PeiaLo/RS485C/README.md

# RS485_C — 多層樹狀傳感器網路

以 RS485 為傳輸骨幹的**多層樹狀**傳感器資料收集系統。頂層為 PC，往下經多層**中繼器**，末端接各類**傳感器模組**（溫度、壓力…）。最終用於**工廠端即時資料收集**：把傳統 PLC 資料轉為 PC 架構，客戶端可即時讀值、設定條件達成自動控制。

> 本專案接替並取代舊的 `R_C_MOD`。與 `ACL_001`（酒測儀）為完全獨立的兩個項目。

---

## 一分鐘理解

```
PC (頂層, 5V / 未來 Ethernet·WiFi)
 └─ RS485 bus (第1層)
     ├─ 中繼器 1  ── RS485 bus (第2層) ── 傳感器 / 更下層中繼器 …
     ├─ 中繼器 2
     └─ …(單一 bus 最多 64 台)
```

- 每台**中繼器**同時扮演兩個角色：對**上層**是 slave（被要求才回話），對**下層**是 master（主動輪詢）。
- 資料流是「**下層一直輪詢+暫存(cache)，上層要才給**」——把 PC 的讀取速度和下層 bus 速度解耦。
- 每台設備都靠**7 階指撥開關**定址；換機時預載好 JSON、撥同一位址即可直接替換。

## 文件導覽

| 文件 | 內容 |
|---|---|
| [docs/01_系統架構.md](docs/01_系統架構.md) | 整體拓樸、角色、資料流、cache 模型（含圖） |
| [docs/02_通訊協定.md](docs/02_通訊協定.md) | `\n`/`\r` byte 串流框架、輪詢時序、逾時、傳輸內容格式 |
| [docs/03_定址與指撥開關.md](docs/03_定址與指撥開關.md) | 7 階指撥、6 位址 + 1 功能、字串分層位址、層數判定 |
| [docs/04_軟體模組拆分.md](docs/04_軟體模組拆分.md) | 6 個可分頭開發的模組、介面契約、開發順序 |
| [docs/05_測試架構建議.md](docs/05_測試架構建議.md) | 用手上硬體（STM32/Nucleo/UNO/ESP32/MAX13487）分階段驗證 |
| [docs/06_設計決策與待確認.md](docs/06_設計決策與待確認.md) | 開放問題、風險、需要你拍板的地方 |
| [docs/07_採購清單.md](docs/07_採購清單.md) | 非陸製 BOM / 採購清單、手上硬體盤點 |
| [子專案/](子專案/00_拆分總覽.md) | **分對話開發用**：6 個模組的 kickoff brief，各含「貼到新對話的開場白」 |
| [schema/](schema/) | 設備 JSON schema 與範例（溫度、壓力） |
| [firmware/](firmware/) | 末端(Arduino) 與 中繼器(MicroPython) 韌體骨架 |
| [pc/](pc/) | PC 上位機骨架 |

## 技術棧

- **末端傳感器模組**：Arduino（C++），單純驅動 + 讀指撥 + 打包傳輸。
- **中繼器**：MicroPython（ESP32），善用 `list`/`dict` 做輪詢佇列與 cache。
- **PC 上位機**：Python（序列埠 / 未來 Ethernet），儀表板 + 規則引擎。
- **RS485 收發器**：MAX13487（AutoDirection，免 DE/RE 方向控制腳）。

## 目前狀態

規格已整理成文件（本次），韌體/軟體為骨架，尚未實作。建議先確定 [docs/06](docs/06_設計決策與待確認.md) 的待拍板項目，並先凍結 [docs/02 通訊協定](docs/02_通訊協定.md) 當作各模組共用契約，再分頭進行。
