PeiaLo/RS485C/docs/07_採購清單.md

# 07 · 採購清單 / BOM（非陸製）

**原則**：晶片產地非中國。ST（歐）、Microchip/TI/ADI（美）、WIZnet（韓）、Semtech（美）、Nordic（挪）、Infineon（德/美）。避開 Espressif(ESP32，中國) 與內含 ESP32 的模組（如 u-blox NINA-W1）。

> 開發板（Blue/Black Pill、UNO 相容板）多為中國組裝但晶片是真的 → **打樣可用；產品走自己的 PCB + 原廠晶片**。Blue Pill F103 常見克隆晶片，產品務必買原廠 ST。

## v2 節點硬體增減（vs 舊 DIP 版，2026-10-13）

> 回答「除了 DIP 去掉還要增減什麼」。細節見 [10](10_自動終端與拓樸.md)、[06 §O](06_設計決策與待確認.md)。

**➕ 新增**
| 件 | 用途 | 代價 |
|---|---|---|
| **ENUM 鏈線 + 2 GPIO/節點** | 自動定址枚舉（`ENUM_IN` 讀 / `ENUM_OUT` 驅） | 連接器 +1 pin、2 GPIO |
| **0.1Ω shunt + INA180**（每節點對下游電源線） | 偵測「我是不是尾」→ 自動終端 + 鏈完整性 | ~260µA/台、1 ADC/比較腳 |
| **可切換終端** | 尾端 120Ω 自動投切（THVD1454 內建，或 PhotoMOS+120Ω） | +1 TERM GPIO |
| **連接器加 pin** | in/out 同順序串 A/B/GND/V+/**ENUM** | 連接器升一級 |
| **頭段 adapter（頂層，可插拔）** | WiFi（非陸製 WINC1500/CYW43439）或 W5500 乙太 | 僅頂層 1 顆 |
| **中繼器第 3 收發器/UART** | UP + DOWN-trunk + DOWN-leaf（[10 §1](10_自動終端與拓樸.md)） | RP2040 需 PIO-UART 或改 STM32 多 USART |
| **末端第 2 RS485 收發器** | 尾段 MODBUS master@115200 對外部外設 | 要接外部外設才需 |

**➖ 移除**
| 件 | 原因 |
|---|---|
| **DIP 開關(7位) + 7 GPIO / 74HC165** | 自動定址取代 |
| **固定焊死尾端 120Ω** | 改可切換自動投切（頭端仍固定 120Ω） |
| **偏壓電阻 2×560Ω/bus** | 改 true fail-safe 收發器 → 免偏壓 |
| **分壓電阻 1.8k/3.3k（RO→RX）** | 改 3.3V 原生 fail-safe 件 → 免分壓 |
| **RST 腳** | 軟體重開（記憶 `firmware-soft-reset`） |
| **AutoDir 收發器(MAX13487)** | 改手動 DE/RE fail-safe 件（+1 DE/RE GPIO，但省偏壓） |

**◻ 不影響硬體**：CRC（純軟體、初期不設、後可加）、自動定址枚舉協定（軟體，只需 ENUM 腳）。

> 淨效果：**省掉 DIP/74HC165/偏壓/分壓/固定終端電阻**，**換來 ENUM 1 線 + INA180/可切換終端 + fail-safe 收發器 + 連接器升級**。整體往「自主、免設定、免手調電阻」走，契合 [10](10_自動終端與拓樸.md) 自動終端路線。

## 手上已有（2026-08-20）
| 品項 | 數量 | 用途 |
|---|---|---|
| Nucleo-F401RE | 2 | 原型／可當末端（**MicroPython 中繼器改用 RP2040**：F401RE build 僅 1 UART，見 [06 §J](06_設計決策與待確認.md)） |
| STM32F401 裸板 | 1 | 末端/備用 |
| STM32F103 | 2 | C++ 末端測試（無 FPU，正式末端首選 F411） |
| MAX13487EES | 10 | RS485 收發器（AutoDirection，現行主用；選型另見 [08 §3.2](08_末端外設_Driver_韌性架構.md)） |
| THVD1426DR | 2 | RS485 收發器（TI，二供備用） |

## 要採購

### MCU
| 角色 | 建議料 | 產地 | 備註 |
|---|---|---|---|
| **中繼器**（MicroPython） | **RP2040**（YD-RP2040 / Pico 等） | Raspberry Pi 🇬🇧 | **雙 UART**（選它主因）；`dict/json` 用於型錄/hot-swap |
| **高速傳送型中繼器** | RP2040 + **W5500** | 🇬🇧/🇰🇷 | Ethernet 骨幹/頂層 |
| **計算與驅動型中繼器** | Raspberry Pi（Python） | 🇬🇧/🇺🇸 | 複雜多迴路 |
| **末端**（C++，通用） | **STM32F411**（F411CEU6 / Nucleo-F411RE） | ST 🇪🇺 | M4F+FPU、16ch ADC、5V 容忍腳；預設料 |
| 末端（重運算/大 cache） | STM32F7 / **H743** / N6 | ST | M7+cache / DP-FPU+16-bit ADC+雙核 / NPU（見 [08 §3.1](08_末端外設_Driver_韌性架構.md)） |
| 末端（測試/低階） | STM32F103（原廠） | ST | 無 FPU，僅測試用 |

### RS485 / 網路 / 無線
| 品項 | 料號 | 產地 | 備註 |
|---|---|---|---|
| RS485 收發器（現行主用） | **MAX13487EES** | ADI 🇺🇸 | AutoDirection，免 DE/RE，但需偏壓。**每末端 1、每中繼器 2** |
| RS485 收發器（選型建議） | **MAX13485E** / TI **THVD2450**·SN65HVD75 | ADI/TI 🇺🇸 | true fail-safe **免偏壓**（3.3V 件免分壓）；見 [08 §3.2](08_末端外設_Driver_韌性架構.md) |
| RS485 收發器（二供） | THVD1426 / THVD1450 | TI 🇺🇸 | 確認方向控制方式（多數 THVD14xx 需 DE/RE GPIO） |
| 頭段有線（頂層，首選） | **WIZnet W5500**（配 RP2040） | WIZnet 🇰🇷 | 乙太，SPI、內建硬體 TCP/IP |
| **頭段無線（頂層，扛大量資訊）** | **Microchip WINC1500** / Infineon **CYW43439** | 🇺🇸/🇩🇪 | **WiFi，非陸製**（ESP32 排除）；查最新供貨。見 [06 §O](06_設計決策與待確認.md) |
| 無線（暫緩，若走 LoRa） | **STM32WL** 或 Semtech SX1262 | ST🇪🇺 / Semtech🇺🇸 | STM32WL＝MCU+LoRa 一顆；低頻寬，只適遠端稀疏節點 |

### 被動件 / 其他（每條 bus / 每節點）
| 品項 | 規格 | 說明 |
|---|---|---|
| 終端電阻 | 120Ω ×2/bus | bus 兩端各一（尾端自動投切，見 [10](10_自動終端與拓樸.md)） |
| Failsafe 偏壓 | 上拉 A、下拉 B（如 560Ω–1k） | 至少一處；或用 true fail-safe 件免偏壓 |
| ~~指撥開關~~ | — | **已拿掉**：改自動定址（[03](03_定址與指撥開關.md)、[10 §8](10_自動終端與拓樸.md)） |
| 自動定址/終端件 | INA180（電流偵測）+ ENUM 線 + 可切換終端件（THVD1454 等） | 自偵尾端 + ENUM 鏈枚舉，見 [10](10_自動終端與拓樸.md) |
| 分壓電阻 | 1k/2k | 5V 節點 TX/RO → 3.3V MCU RX |
| 連接器 | RS485 A/B/GND、電源、**ENUM**（in/out 同順序串接） | 依板，見 [10 §4/§8](10_自動終端與拓樸.md) |
| 燒錄器 | ST-Link | Nucleo 已內建 |

## 自製板（雕刻機）
- 先做**兩層**測試；避免麵包板混亂 → 雕刻機刻板（線寬 > 0.35mm，RS485 低速綽綽有餘）。
- 建議先刻：①末端節點板（MCU + 收發器 + INA180/ENUM 自動定址 + 接頭）②bus 背板/接線板（含終端+偏壓）。要我出簡單板子的佈局再說。
