PeiaLo/RS485C/docs/04_軟體模組拆分.md

# 04 · 軟體模組拆分（分頭開發）

> ⚠️ **平台/編碼以 [09 軟體架構定案](09_軟體架構定案.md) 為準**：末端=**C++/STM32**、中繼器=**MicroPython/RP2040**、傳輸層=**RS485↔Ethernet(W5500)**、編碼=**DESC=JSON/REQ=純值CSV+CRC**。本文保留模組拆分脈絡，平台字樣已同步更新。

目標：把系統切成**可獨立、可平行開發**的模組，彼此只靠[通訊協定 02](02_通訊協定.md) 與 [JSON schema](../schema) 這兩份「契約」對接。**先凍結契約，再分頭做。**

## 模組總覽

```mermaid
graph LR
    C[C 共用協定庫<br/>framing + 位址字串<br/>C++ & Python 兩版]

    A[A 末端傳感器韌體<br/>C++ / STM32] -->|用| C
    B[B 中繼器韌體<br/>MicroPython / RP2040] -->|用| C
    D[D PC 上位機<br/>Python] -->|用| C
    E[E JSON schema + 設備庫] -.驗證.-> A
    E -.載入.-> B
    E -.顯示.-> D
    F[F 傳輸層抽象<br/>RS485 ↔ Ethernet] -.可插拔.-> B
    F -.可插拔.-> D

    classDef contract fill:#3a2f5f,stroke:#9a7bd9,color:#fff;
    class C,E contract;
```

## 各模組規格

### 模組 C — 共用協定庫（**最先做，是契約**）
- **內容**：`\n`/`\r` 框架的**編碼/解碼**、位址字串操作（前綴、切段、驗證）、（可選）CRC。
- **兩份實作**（行為必須一致）：
  - `protocol.h/.cpp`（C++，給模組 A）
  - `protocol.py`（Python，給模組 B 的 MicroPython 與模組 D 的 CPython 共用）
- **交付**：一組跨語言一致的單元測試向量（同一輸入 → 同一輸出），確保三邊實作對得上。
- **負責人**：定義協定的人；其他模組等這個先定版。

### 模組 A — 末端傳感器韌體（C++ / STM32）
- **平台**：STM32（F411 通用 → F7/H7 重運算，見 [08 §3.1](08_末端外設_Driver_韌性架構.md)）。
- **職責（單純驅動 + 傳輸）**：
  1. 自動定址（ENUM 鏈序，取代指撥；見 [03](03_定址與指撥開關.md)、[10 §8](10_自動終端與拓樸.md)）。
  2. 讀感測器（driver 登錄表=函式指標），按 descriptor 指向值槽。
  3. 用模組 C 打包：`<本地位址>|<值CSV>*<crc>\r`（REQ 純值 CSV），被輪詢才回。
  4. 功能位 OFF 時進編輯模式，接受寫入自有 JSON/參數。
- **不做**：不輪詢、不 cache、不拼全路徑（那是中繼器的事）。
- **骨架**：[../firmware/stm32_terminal/](../firmware/stm32_terminal)

### 模組 B — 中繼器韌體（MicroPython / RP2040）
- **平台**：RP2040（MicroPython，雙 UART；`dict`/`json` 用在型錄/路由/hot-swap）。
- **職責**：
  1. **雙 UART**：上層 bus（slave 角色）+ 下層 bus（master 角色）。
  2. **輪詢迴圈**：round-robin 問下層每個孩子，收 `\r` 存 cache、逾時跳過。
  3. **cache**：`dict{本地位址: (最新完整資料, 時戳, fresh/stale)}`。
  4. **前綴**：把孩子資料前綴自己的本地位址，向上拼路徑。
  5. **上層要求優先**：被上層要就回 cache。
  6. **型錄**：載入所有已知設備 JSON（catalog）以辨識下層、支援 hot-swap。
- **骨架**：[../firmware/rp2040_repeater/](../firmware/rp2040_repeater)

### 模組 D — PC 上位機（Python）
- **職責**：
  1. 連線（序列埠；未來走模組 F 換 Ethernet）。
  2. **請求排程**：向第 1 層中繼器要資料（全部 / 指定位址）。
  3. 解析框架 → 更新設備即時值表。
  4. **設備資料庫**：用 JSON schema 呈現/驗證各設備。
  5. **即時儀表板**：即時數值、樹狀拓樸、新鮮度。
  6. **規則引擎**（[需求 17]）：使用者設條件（如溫度>X 觸發輸出）→ 自動控制輸出。
  7. Log / 匯出。
- **骨架**：[../pc/](../pc)

### 模組 E — JSON schema + 設備庫
- **內容**：設備 JSON 的 schema、各型別範例、驗證工具。
- **交付**：`device.schema.json` + 每種傳感器一個範例 + 驗證腳本。
- **骨架**：[../schema/](../schema)

### 模組 F — 傳輸層抽象（擴充，之後做）
- **動機**（[需求 11]）：層數/數量變多時 PC 端 RS485 接收會塞車 → 頂層鏈路改 Ethernet（RP2040+W5500）。
- **內容**：定義 `Link` 介面（`send_bytes` / `recv_bytes`），提供 `RS485Link` 與 `EthernetLink` 實作；模組 B（頂層中繼器）與模組 D 只依賴介面，不綁死實體層。WiFi/ESP32 排除（去陸製）。

## 建議開發順序

```mermaid
graph LR
    C[① 模組 C 協定庫<br/>+ 測試向量] --> E[② 模組 E schema]
    C --> A[③ 模組 A 末端]
    C --> B[④ 模組 B 中繼器]
    A --> T0[⑤ 兩節點對接<br/>見 05]
    B --> T0
    T0 --> D[⑥ 模組 D PC + 多層]
    D --> F[⑦ 模組 F 換 Ethernet]
```

1. **先定 C（協定）+ E（schema）** — 這是所有人共用的契約，先凍結。
2. A / B 可同時開工（都依 C）。
3. 先做 **A↔B 兩節點對接**（[05 測試 Stage 0](05_測試架構建議.md)）驗證框架與定址。
4. 再上 **D（PC）+ 多層樹**。
5. 最後 **F（Ethernet, W5500）** 解 PC 端瓶頸。

## 分工建議（若多人）

| 人 | 模組 | 前置依賴 |
|----|---|---|
| 韌體 A | A 末端(STM32/C++) + C 的 C++ 版 | 協定定版 |
| 韌體 B | B 中繼器(RP2040/MicroPython) + C 的 Python 版 | 協定定版 |
| 上位機 | D PC + 規則引擎 | 協定定版、schema |
| 資料/系統 | E schema + F 傳輸層 | — |
