PeiaLo/RS485C/子專案/00_拆分總覽.md

# 子專案拆分總覽

把 RS485_C 拆成可**分對話平行開發**的子專案。每個子專案一份 kickoff brief（本資料夾），
裡面有「**貼到新對話的開場白**」——新對話冷啟動時貼那段就能接上完整脈絡。

## 運作方式

- **單一 repo（mono-repo）**：https://github.com/PeiaLo/RS485C ，本機 `C:\Users\apial\Desktop\RS485_C`。
- 每個子專案 = repo 裡一個資料夾，**用各自的對話開發**，都 push 回同一個 repo。
- **共用契約**＝[docs/02 通訊協定](../docs/02_通訊協定.md) 與 [schema/](../schema)。任何模組**不可自行改契約**；要改先回「契約對話（C/E）」統一改，再讓大家 pull。
- 新對話開發流程：`git pull` → 改自己的資料夾 → commit → `git push`。其他對話 pull 就同步。

## 拆分地圖

| 子專案 | 資料夾 | 語言/平台 | 依賴 | 建議順序 | 狀態 |
|---|---|---|---|---|---|
| [C 協定庫](C_協定庫.md) | `lib/` | C++ & Python | — | **①先做（契約）** | 已抽出 `lib/protocol.*`；CRC-16 待啟用 |
| [E JSON schema](E_schema.md) | `schema/` | JSON | — | **①先做（契約）** | schema+範例已建，待驗證腳本 |
| [A 末端韌體](A_末端韌體.md) | `firmware/stm32_terminal/` | **C++ / STM32**（F411…H7） | C | ② | 深鏈末端已驗通（健康監測+IWDG） |
| [B 中繼器韌體](B_中繼器韌體.md) | `firmware/rp2040_repeater/` | **MicroPython / RP2040** | C, E | ② | 深鏈 3 層中繼已驗通（前綴+cache 解耦） |
| [D PC 上位機](D_PC上位機.md) | `pc/` | Python | C, E | ③ | 已有 `rs485_monitor.py`/`rs485_probe.py`；上位機待實作 |
| [F 傳輸層](F_傳輸層.md) | `pc/`, `firmware/` | **Python / RP2040(W5500)** | B, D | ④ 擴充 | 只有概念 |

## 依賴與順序

```mermaid
graph LR
    C[C 協定庫 契約] --> A[A 末端]
    C --> B[B 中繼器]
    C --> D[D PC]
    E[E schema 契約] --> B
    E --> D
    A --> S1[Stage1 對接]
    B --> S1
    S1 --> D
    D --> F[F 傳輸層]
```

**建議的開對話節奏**：

1. **先開「契約對話」**：一次把 C（協定庫）+ E（schema）定版凍結。這是其他所有模組的地基。
2. 契約定版後，**A、B、D 可以三個對話平行跑**（各依賴契約，彼此不擋）。
3. 先讓 **A + B 做 Stage 1 對接**（一台中繼器接多末端），再上 **D（PC）**。
4. **F（傳輸層/Ethernet W5500）** 最後，等真的遇到頻寬或跨棟需求。

## 每個子專案 brief 的固定結構

目標 → 範圍(做/不做) → 依賴契約 → 介面 → 交付物 → 完成定義(DoD) → 目前狀態 → **📋 開新對話貼這段**。

> 提醒（v2 定架，[docs/06 §O](../docs/06_設計決策與待確認.md)）：**三段式**——頭段(PC 側，可插拔傳輸：RS485/乙太/WiFi 非陸製)／**核心 RS485 私有格式 `0xFE`**(不動)／尾段(外設側，可插拔協定：**MODBUS 預設但不限**)。**第一 byte 判別**（`1-63`/`0xFF`=MODBUS、`0xFE`=私有）。**外設不進樹狀定址**（path 只到節點，末端 cache+**JSON descriptor** 索引）。**定址＝自動定址（ENUM 枚舉，DIP 拿掉）**。CRC-16/MODBUS。唯一真相在 [docs/02 §3.1](../docs/02_通訊協定.md)、[docs/06 §N/§O](../docs/06_設計決策與待確認.md)、[docs/03](../docs/03_定址與指撥開關.md)、[docs/10 §8](../docs/10_自動終端與拓樸.md)、[docs/09](../docs/09_軟體架構定案.md)。
