PeiaLo/RS485C/hardware/PCB/RS485_C_repeater.kicad_pcb

## KiCad design hardware/PCB/RS485_C_repeater.kicad_pcb (2026-10-31)

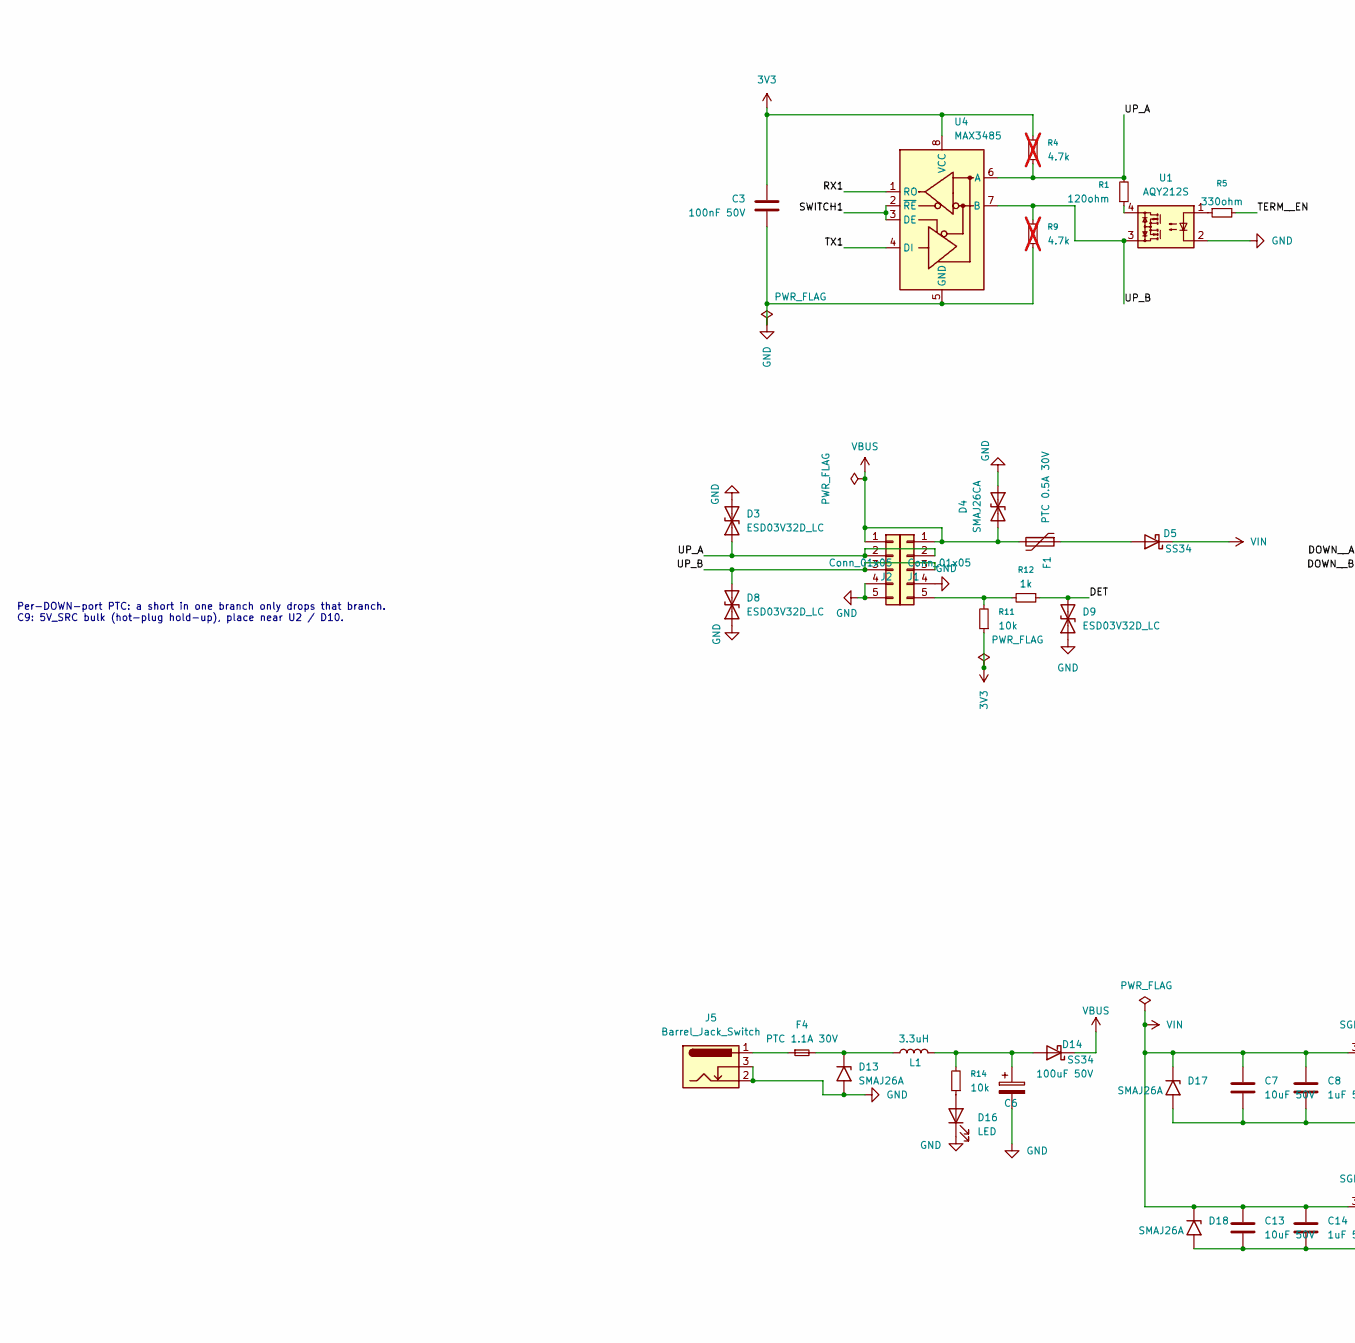
[picture p5: schematic RS485_C_repeater.kicad_sch, part in row 1, column 1]

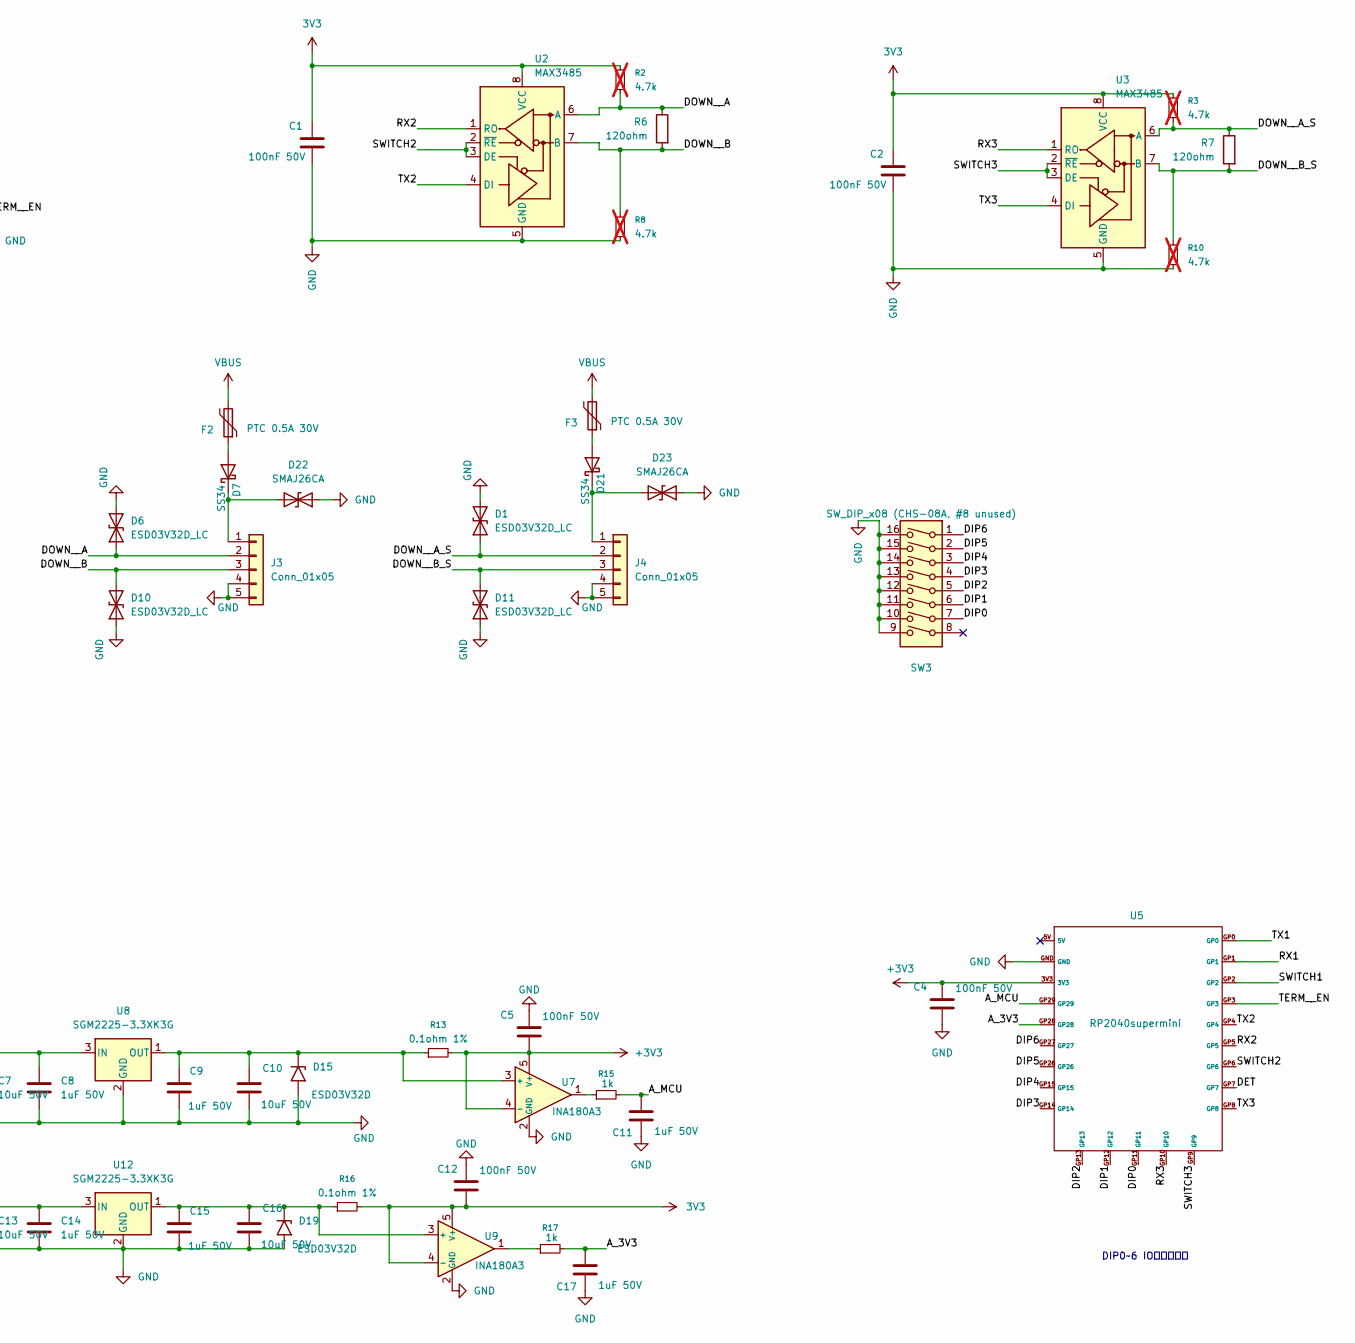
[picture p6: schematic RS485_C_repeater.kicad_sch, part in row 1, column 2]

Parts:
C1, C2, C3, C4, C5, C12: 100nF 50V; C_0805_2012Metric_Pad1.18x1.45mm_HandSolder
C6: 100uF 50V; CP_Radial_D8.0mm_P3.50mm
C7, C10, C13, C16: 10uF 50V; C_1206_3216Metric_Pad1.33x1.80mm_HandSolder
C8, C9, C11, C14, C15, C17: 1uF 50V; C_0805_2012Metric_Pad1.18x1.45mm_HandSolder
D1, D3, D6, D8, D9, D10, D11: ESD03V32D_LC; D_SOD-323_RECT
D4, D22, D23: SMAJ26CA; D_SMA
D5, D7, D14, D21: SS34; D_SMA
D13, D17, D18: SMAJ26A; D_SMA
D15, D19: ESD03V32D; D_SOD-323_RECT
D16: LED; LED_0805_2012Metric_Pad1.15x1.40mm_HandSolder
F1, F2, F3: PTC 0.5A 30V; Fuse_1206_3216Metric_Pad1.42x1.75mm_HandSolder
F4: PTC 1.1A 30V; Fuse_1206_3216Metric_Pad1.42x1.75mm_HandSolder
J1, J2, J3, J4: Conn_01x05; Molex_SL_171971-0005_1x05_P2.54mm_Vertical
J5: Barrel_Jack_Switch; BarrelJack_GCT_DCJ200-10-A_Horizontal
L1: 3.3uH; L_Changjiang_FXL0420
R1, R6, R7: 120ohm; R_0805_2012Metric_Pad1.20x1.40mm_HandSolder
R2, R3, R4, R8, R9, R10: 4.7k; R_0805_2012Metric_Pad1.20x1.40mm_HandSolder; not fitted
R5: 330ohm; R_0805_2012Metric_Pad1.20x1.40mm_HandSolder
R11, R14: 10k; R_0805_2012Metric_Pad1.20x1.40mm_HandSolder
R12, R15, R17: 1k; R_0805_2012Metric_Pad1.20x1.40mm_HandSolder
R13, R16: 0.1ohm 1%; R_0805_2012Metric_Pad1.20x1.40mm_HandSolder
SW3: SW_DIP_x08 (CHS-08A, #8 unused); SW_DIP_SPSTx08_Slide_Copal_CHS-08A_W5.08mm_P1.27mm_JPin
U1: AQY212S; SO-4_4.4x4.3mm_P2.54mm_AQY212S_HandSolder
U2, U3, U4: MAX3485; SOIC127P600X175-8N
U5: RP2040supermini; RP2040_Super_Mini_Socket
U7, U9: INA180A3; SOT-23-5
U8, U12: SGM2225-3.3XK3G; SOT-89-3_SGM2225_Handsoldering_Engrave

Connections:
3V3: C1.1, C2.1, C3.1, C12.2, R2.2, R3.2, R4.2, R11.1, R16.2, U2.8 (VCC), U3.8 (VCC), U4.8 (VCC), U9.4 (-), U9.5 (V+)
+3V3: C4.1, C5.2, R13.2, U5.3V3, U7.4 (-), U7.5 (V+)
/A_3V3: C17.2, R17.2, U5.GP28
/A_MCU: C11.2, R15.2, U5.GP29
/DET: D9.2 (A2), R12.1, U5.GP7
/DIP0: SW3.7, U5.GP11
/DIP1: SW3.6, U5.GP12
/DIP2: SW3.5, U5.GP13
/DIP3: SW3.4, U5.GP14
/DIP4: SW3.3, U5.GP15
/DIP5: SW3.2, U5.GP26
/DIP6: SW3.1, U5.GP27
/DOWN__A: D6.1 (A1), J3.2, R2.1, R6.1, U2.6 (A)
/DOWN__A_S: D1.1 (A1), J4.2, R3.1, R7.1, U3.6 (A)
/DOWN__B: D10.2 (A2), J3.3, R6.2, R8.2, U2.7 (B)
/DOWN__B_S: D11.2 (A2), J4.3, R7.2, R10.2, U3.7 (B)
/RX1: U4.1 (RO), U5.GP1
/RX2: U2.1 (RO), U5.GP5
/RX3: U3.1 (RO), U5.GP10
/SWITCH1: U4.2 (~RE), U4.3 (DE), U5.GP2
/SWITCH2: U2.2 (~RE), U2.3 (DE), U5.GP6
/SWITCH3: U3.2 (~RE), U3.3 (DE), U5.GP9
/TERM__EN: R5.2, U5.GP3
/TX1: U4.4 (DI), U5.GP0
/TX2: U2.4 (DI), U5.GP4
/TX3: U3.4 (DI), U5.GP8
/UP_A: D3.1 (A1), J1.2, J2.2, R1.2, R4.1, U4.6 (A)
/UP_B: D8.2 (A2), J1.3, J2.3, R9.2, U1.3, U4.7 (B)
GND: C1.2, C2.2, C3.2, C4.2, C5.1, C6.2, C7.2, C8.2, C9.2, C10.2, C11.1, C12.1, C13.2, C14.2, C15.2, C16.2, C17.1, D1.2 (A2), D3.2 (A2), D4.1 (A1), D6.2 (A2), D8.1 (A1), D9.1 (A1), D10.1 (A1), D11.1 (A1), D13.2 (A2), D15.2 (A2), D16.1 (K), D17.2 (A2), D18.2 (A2), D19.2 (A2), D22.1 (A1), D23.1 (A1), J1.4, J1.5, J2.4, J3.4, J3.5, J4.4, J4.5, J5.2, J5.3, R8.1, R9.1, R10.1, SW3.9, SW3.10, SW3.11, SW3.12, SW3.13, SW3.14, SW3.15, SW3.16, U1.2, U2.5 (GND), U3.5 (GND), U4.5 (GND), U5.GND, U7.2 (GND), U8.2 (GND), U9.2 (GND), U12.2 (GND)
unnamed: D5.2 (A), F1.1
unnamed: D7.2 (A), F2.1
unnamed: D13.1 (A1), F4.2, L1.1
unnamed: C6.1, D14.2 (A), L1.2, R14.2
unnamed: C9.1, C10.1, D15.1 (A1), R13.1, U7.3 (+), U8.1 (OUT)
unnamed: D16.2 (A), R14.1
unnamed: C15.1, C16.1, D19.1 (A1), R16.1, U9.3 (+), U12.1 (OUT)
unnamed: D21.2 (A), F3.1
unnamed: D21.1 (K), D23.2 (A2), J4.1
unnamed: D7.1 (K), D22.2 (A2), J3.1
unnamed: F4.1, J5.1
unnamed: J2.5, R11.2, R12.2
unnamed: R1.1, U1.4
unnamed: R5.1, U1.1
unnamed: R15.1, U7.1
unnamed: R17.1, U9.1
VBUS: D4.2 (A2), D14.1 (K), F1.2, F2.2, F3.2, J1.1, J2.1
VIN: C7.1, C8.1, C13.1, C14.1, D5.1 (K), D17.1 (A1), D18.1 (A1), U8.3 (IN), U12.3 (IN)

Notes on the sheet:
Per-DOWN-port PTC: a short in one branch only drops that branch. C9: 5V_SRC bulk (hot-plug hold-up), place near U2 / D10.
DIP0~6 IO採內建上拉

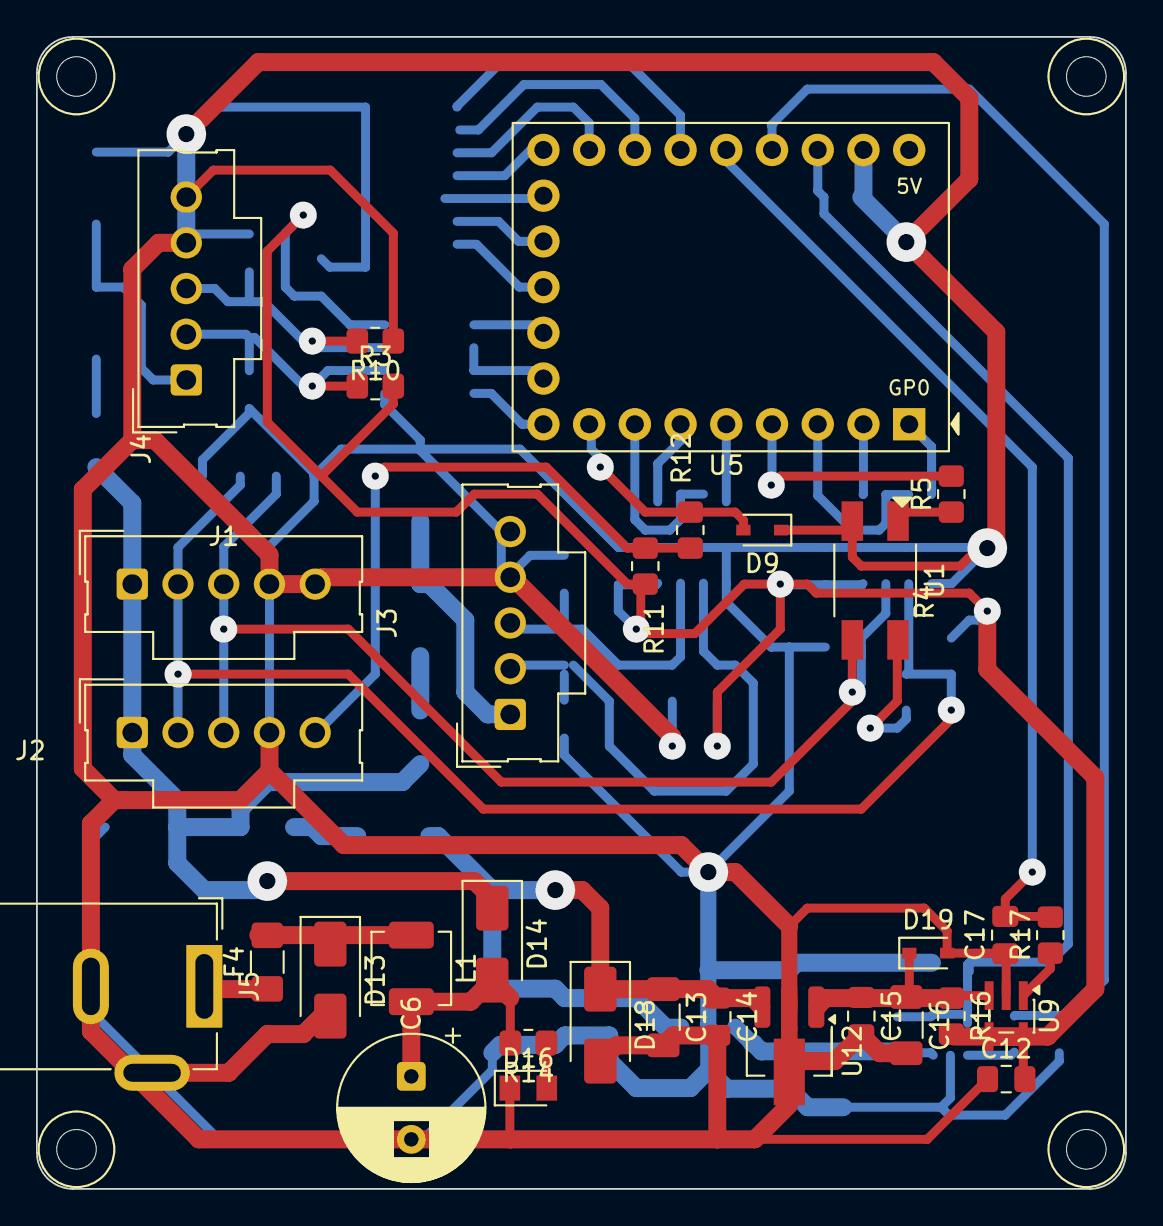
[picture p7: board RS485_C_repeater.kicad_pcb from above]

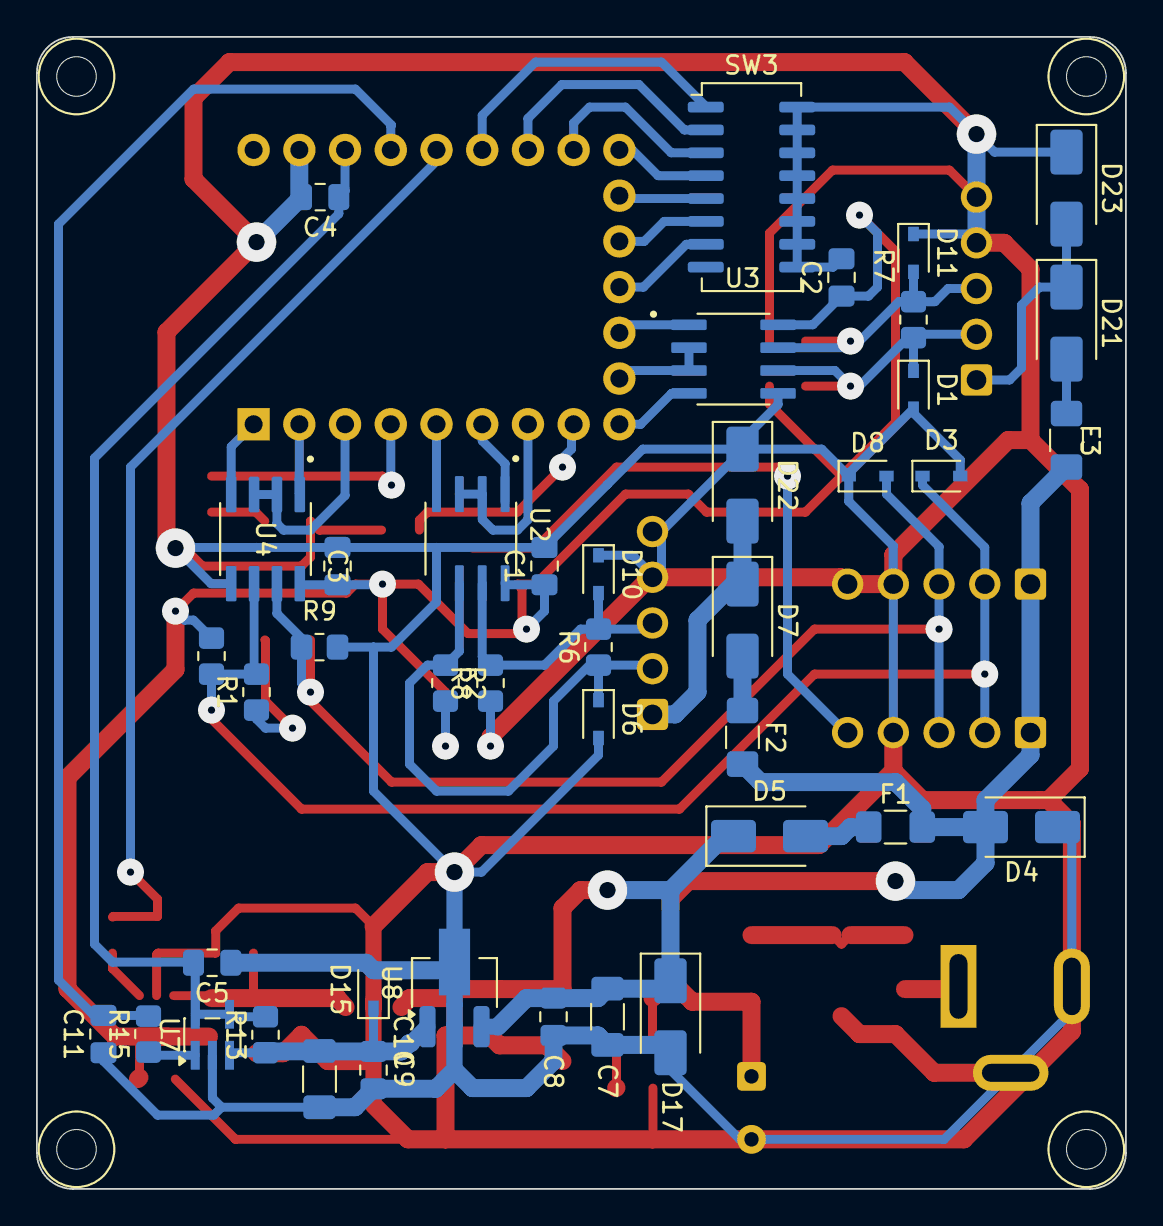
[picture p8: board RS485_C_repeater.kicad_pcb from below]

Board: 2 copper layers, 60.5 x 64.0 mm, 75 parts (42 on the bottom side), 47 nets.

Other parts of the board:
BRD1: Outline_M2; RS485_C_repeater_Outline_M2
