PeiaLo/RS485C/hardware/PCB/RS485_C_terminal.kicad_pcb

## KiCad design hardware/PCB/RS485_C_terminal.kicad_pcb (2026-10-31)

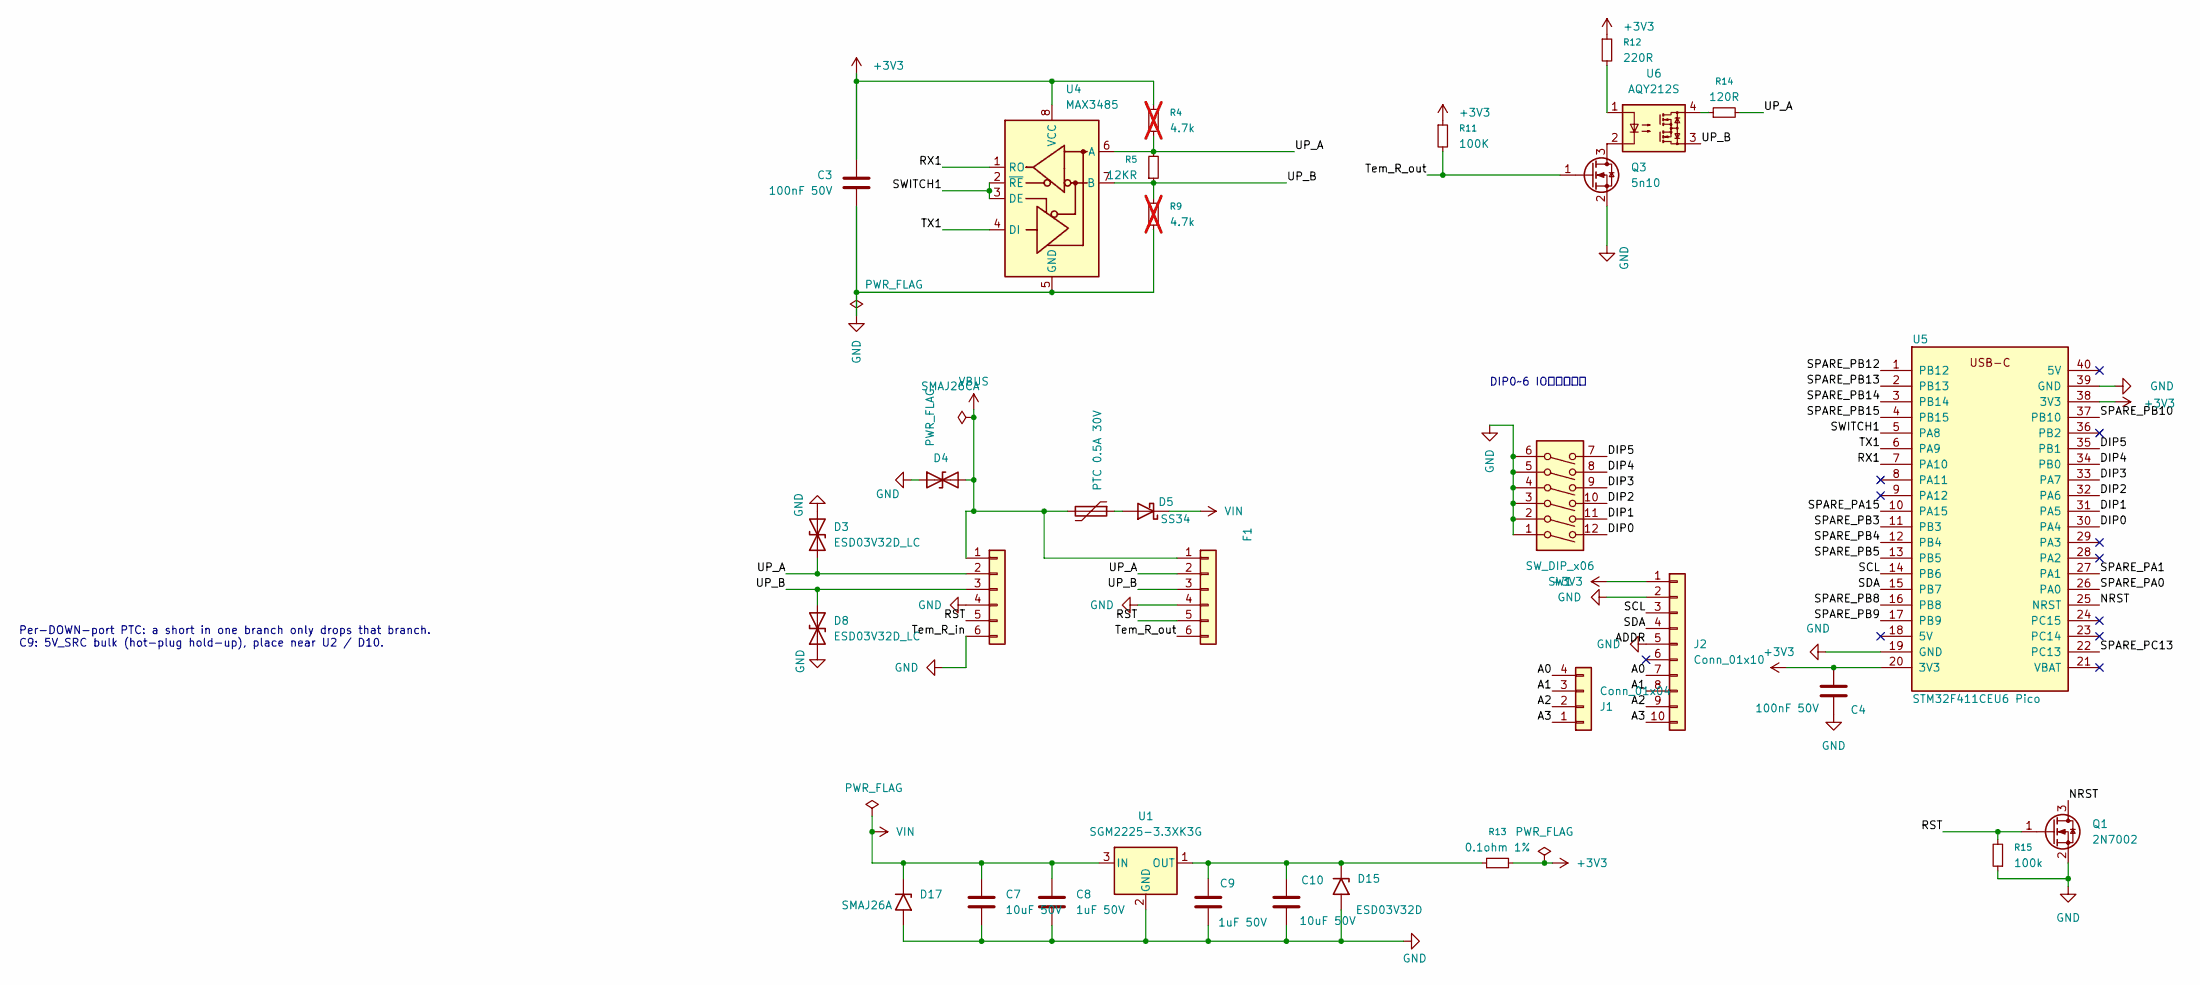
[picture p9: schematic RS485_C_terminal.kicad_sch]

Parts:
C3, C4: 100nF 50V; C_0805_2012Metric_Pad1.18x1.45mm_HandSolder_RECT
C7, C10: 10uF 50V; C_1206_3216Metric_Pad1.33x1.80mm_HandSolder_RECT
C8, C9: 1uF 50V; C_0805_2012Metric_Pad1.18x1.45mm_HandSolder_RECT
D3, D8: ESD03V32D_LC; D_SOD-323_RECT
D4: SMAJ26CA; D_SMA_RECT
D5: SS34; D_SMA_RECT
D15: ESD03V32D; D_SOD-323_RECT
D17: SMAJ26A; D_SMA_RECT
F1: PTC 0.5A 30V; Fuse_1206_3216Metric_Pad1.42x1.75mm_HandSolder_RECT
J1: Conn_01x04; PinHeader_1x04_P2.54mm_Vertical_RECT
J2: Conn_01x10; PinHeader_1x10_P2.54mm_Vertical_RECT
J8, J9: Conn_01x06; PinHeader_1x06_P2.54mm_Horizontal_RECT
Q1: 2N7002; SOT-23_RECT
Q3: 5n10; SOT-23_RECT
R4, R9: 4.7k; R_0805_2012Metric_Pad1.20x1.40mm_HandSolder_RECT; not fitted
R5: 12KR; R_0805_2012Metric_Pad1.20x1.40mm_HandSolder_RECT
R11: 100K; R_0805_2012Metric_Pad1.20x1.40mm_HandSolder_RECT
R12: 220R; R_0805_2012Metric_Pad1.20x1.40mm_HandSolder_RECT
R13: 0.1ohm 1%; R_0805_2012Metric_Pad1.20x1.40mm_HandSolder_RECT
R14: 120R; R_0805_2012Metric_Pad1.20x1.40mm_HandSolder_RECT
R15: 100k; R_0805_2012Metric_Pad1.20x1.40mm_HandSolder_RECT
SW1: SW_DIP_x06; SW_DIP_SPSTx06_Slide_KingTek_DSHP06TS_W7.62mm_P1.27mm_RECT
U1: SGM2225-3.3XK3G; SOT-89-3_SGM2225_Handsoldering_Engrave_RECT
U4: MAX3485; SOIC127P600X175-8N_RECT
U5: STM32F411CEU6 Pico; STM32F411_Pico_Socket_2x20_W17.78mm_RECT
U6: AQY212S; SO-4_4.4x4.3mm_P2.54mm_RECT

Connections:
+3V3: C3.1, C4.2, J2.1, R4.2, R11.1, R12.1, R13.2, U4.8 (VCC), U5.20 (3V3), U5.38 (3V3)
/A0: J1.4, J2.7
/A1: J1.3, J2.8
/A2: J1.2, J2.9
/A3: J1.1, J2.10
/DIP0: SW1.12, U5.30 (PA4)
/DIP1: SW1.11, U5.31 (PA5)
/DIP2: SW1.10, U5.32 (PA6)
/DIP3: SW1.9, U5.33 (PA7)
/DIP4: SW1.8, U5.34 (PB0)
/DIP5: SW1.7, U5.35 (PB1)
/NRST: Q1.3 (D), U5.25 (NRST)
/RST: J8.5, J9.5, Q1.1 (G), R15.2
/RX1: U4.1 (RO), U5.7 (PA10)
/SCL: J2.3, U5.14 (PB6)
/SDA: J2.4, U5.15 (PB7)
/SPARE_PA0: U5.26 (PA0)
/SPARE_PA1: U5.27 (PA1)
/SPARE_PA15: U5.10 (PA15)
/SPARE_PB3: U5.11 (PB3)
/SPARE_PB4: U5.12 (PB4)
/SPARE_PB5: U5.13 (PB5)
/SPARE_PB8: U5.16 (PB8)
/SPARE_PB9: U5.17 (PB9)
/SPARE_PB10: U5.37 (PB10)
/SPARE_PB12: U5.1 (PB12)
/SPARE_PB13: U5.2 (PB13)
/SPARE_PB14: U5.3 (PB14)
/SPARE_PB15: U5.4 (PB15)
/SPARE_PC13: U5.22 (PC13)
/SWITCH1: U4.2 (~RE), U4.3 (DE), U5.5 (PA8)
/TX1: U4.4 (DI), U5.6 (PA9)
/Tem_R_out: J9.6, Q3.1 (G), R11.2
/UP_A: D3.1 (A1), J8.2, J9.2, R4.1, R5.2, R14.2, U4.6 (A)
/UP_B: D8.2 (A2), J8.3, J9.3, R5.1, R9.2, U4.7 (B), U6.3
GND: C3.2, C4.1, C7.2, C8.2, C9.2, C10.2, D3.2 (A2), D4.1 (A1), D8.1 (A1), D15.2 (A2), D17.2 (A2), J2.2, J2.5, J8.4, J8.6, J9.4, Q1.2 (S), Q3.2 (S), R9.1, R15.1, SW1.1, SW1.2, SW1.3, SW1.4, SW1.5, SW1.6, U1.2 (GND), U4.5 (GND), U5.19 (GND), U5.39 (GND)
unnamed: D5.2 (A), F1.1
unnamed: C9.1, C10.1, D15.1 (A1), R13.1, U1.1 (OUT)
unnamed: Q3.3 (D), U6.2
unnamed: R12.2, U6.1
unnamed: R14.1, U6.4
VBUS: D4.2 (A2), F1.2, J8.1, J9.1
VIN: C7.1, C8.1, D5.1 (K), D17.1 (A1), U1.3 (IN)

Notes on the sheet:
Per-DOWN-port PTC: a short in one branch only drops that branch. C9: 5V_SRC bulk (hot-plug hold-up), place near U2 / D10.
DIP0~6 IO採內建上拉

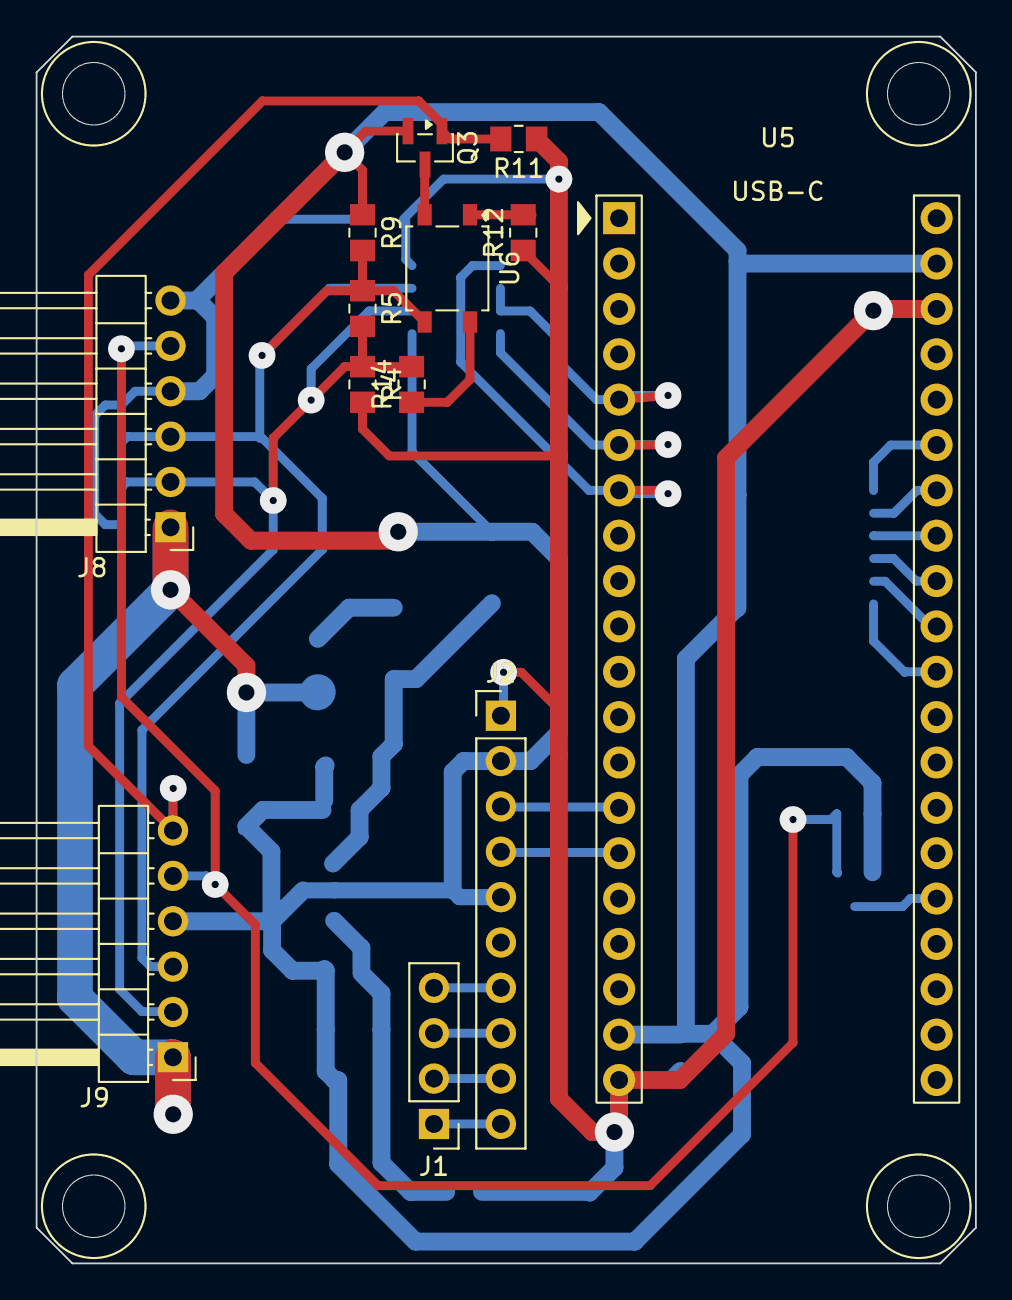
[picture p10: board RS485_C_terminal.kicad_pcb from above]

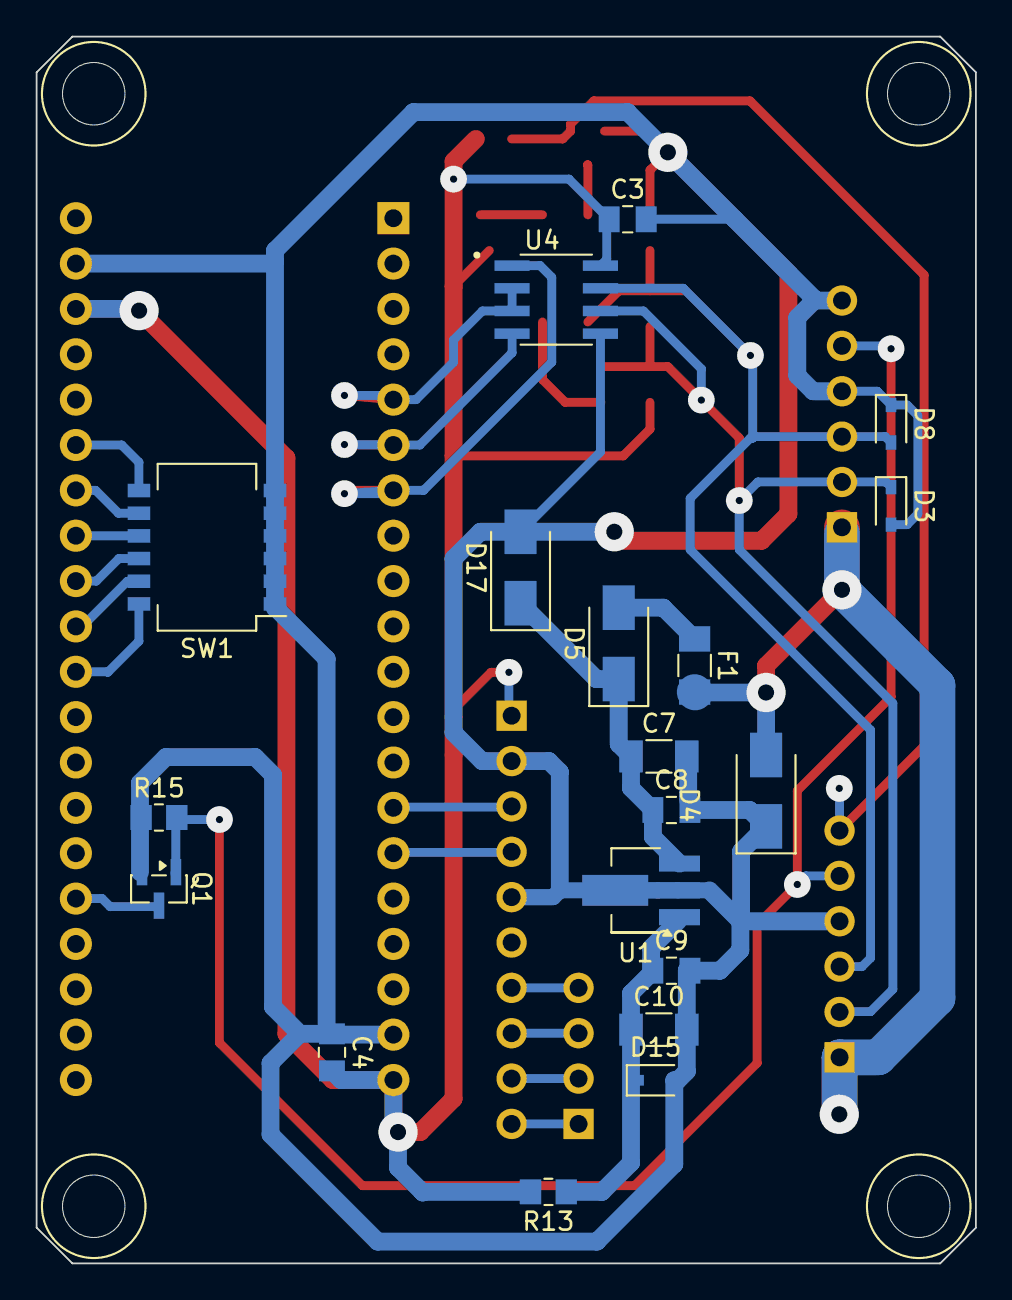
[picture p11: board RS485_C_terminal.kicad_pcb from below]

Board: 2 copper layers, 52.6 x 68.7 mm, 33 parts (19 on the bottom side), 29 nets.

Other parts of the board:
BRD1: Outline_M3; RS485_C_terminal_Outline_M3
