PeiaLo/RS485C/hardware/PCB/RS485_C_repeater_YJ.kicad_pcb

## KiCad design hardware/PCB/RS485_C_repeater_YJ.kicad_pcb (2026-10-31)

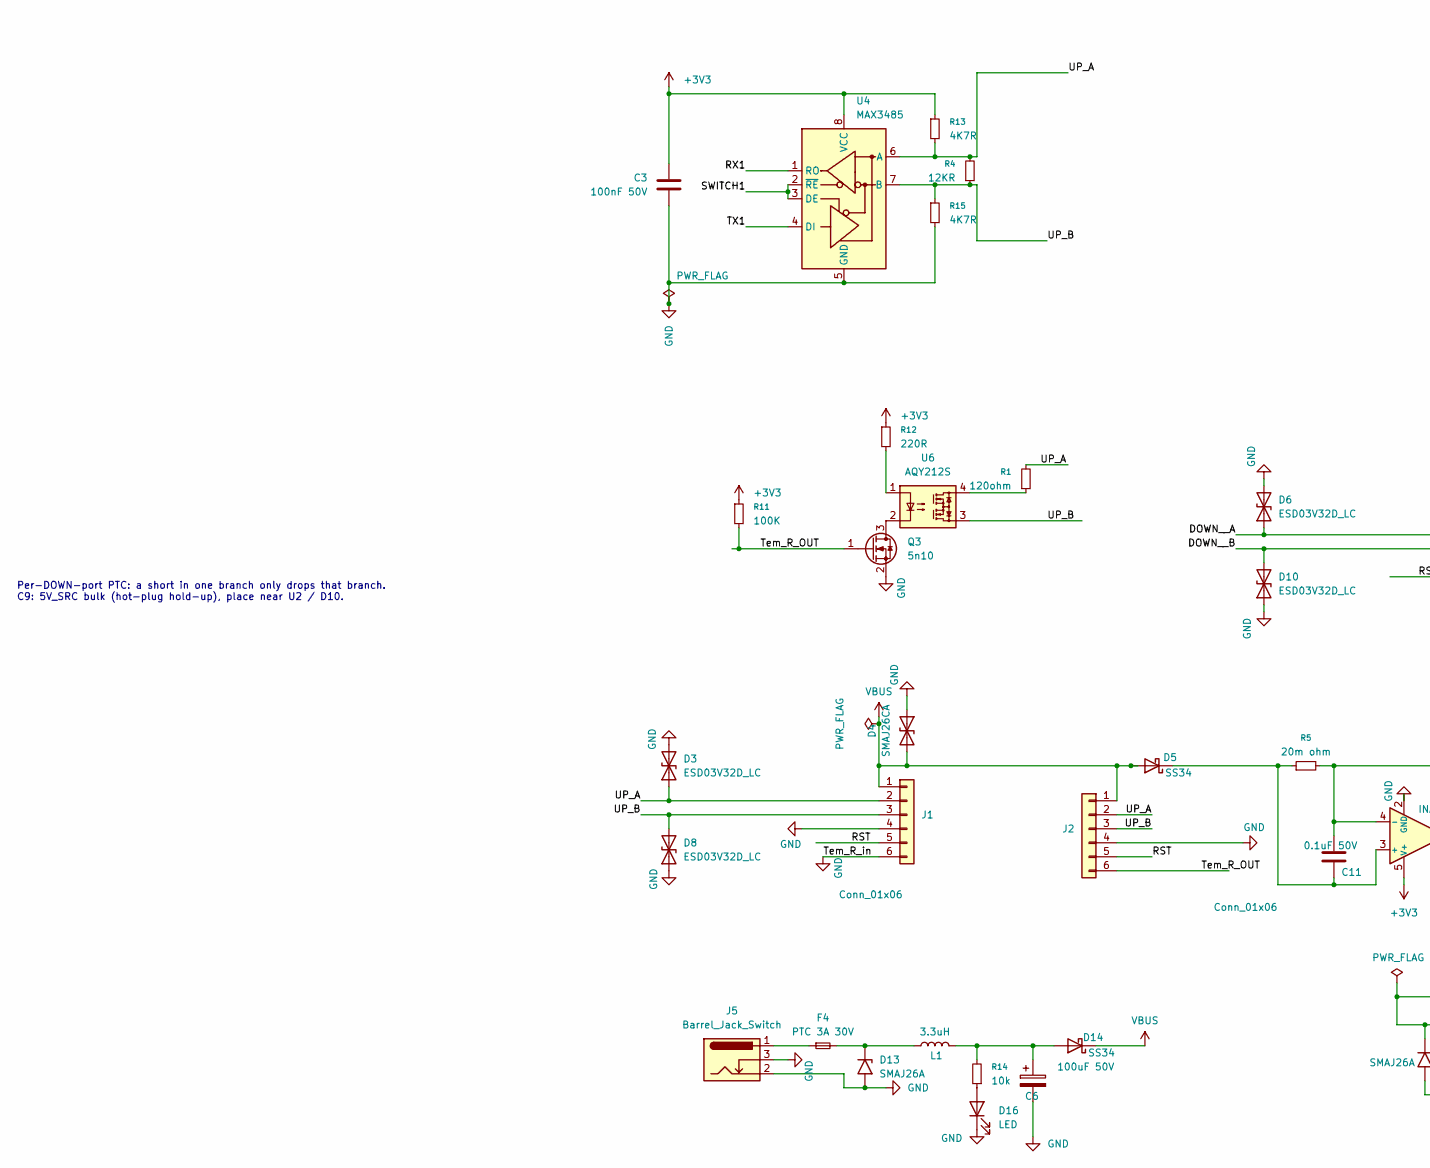
[picture p12: schematic RS485_C_repeater_YJ.kicad_sch, part in row 1, column 1]

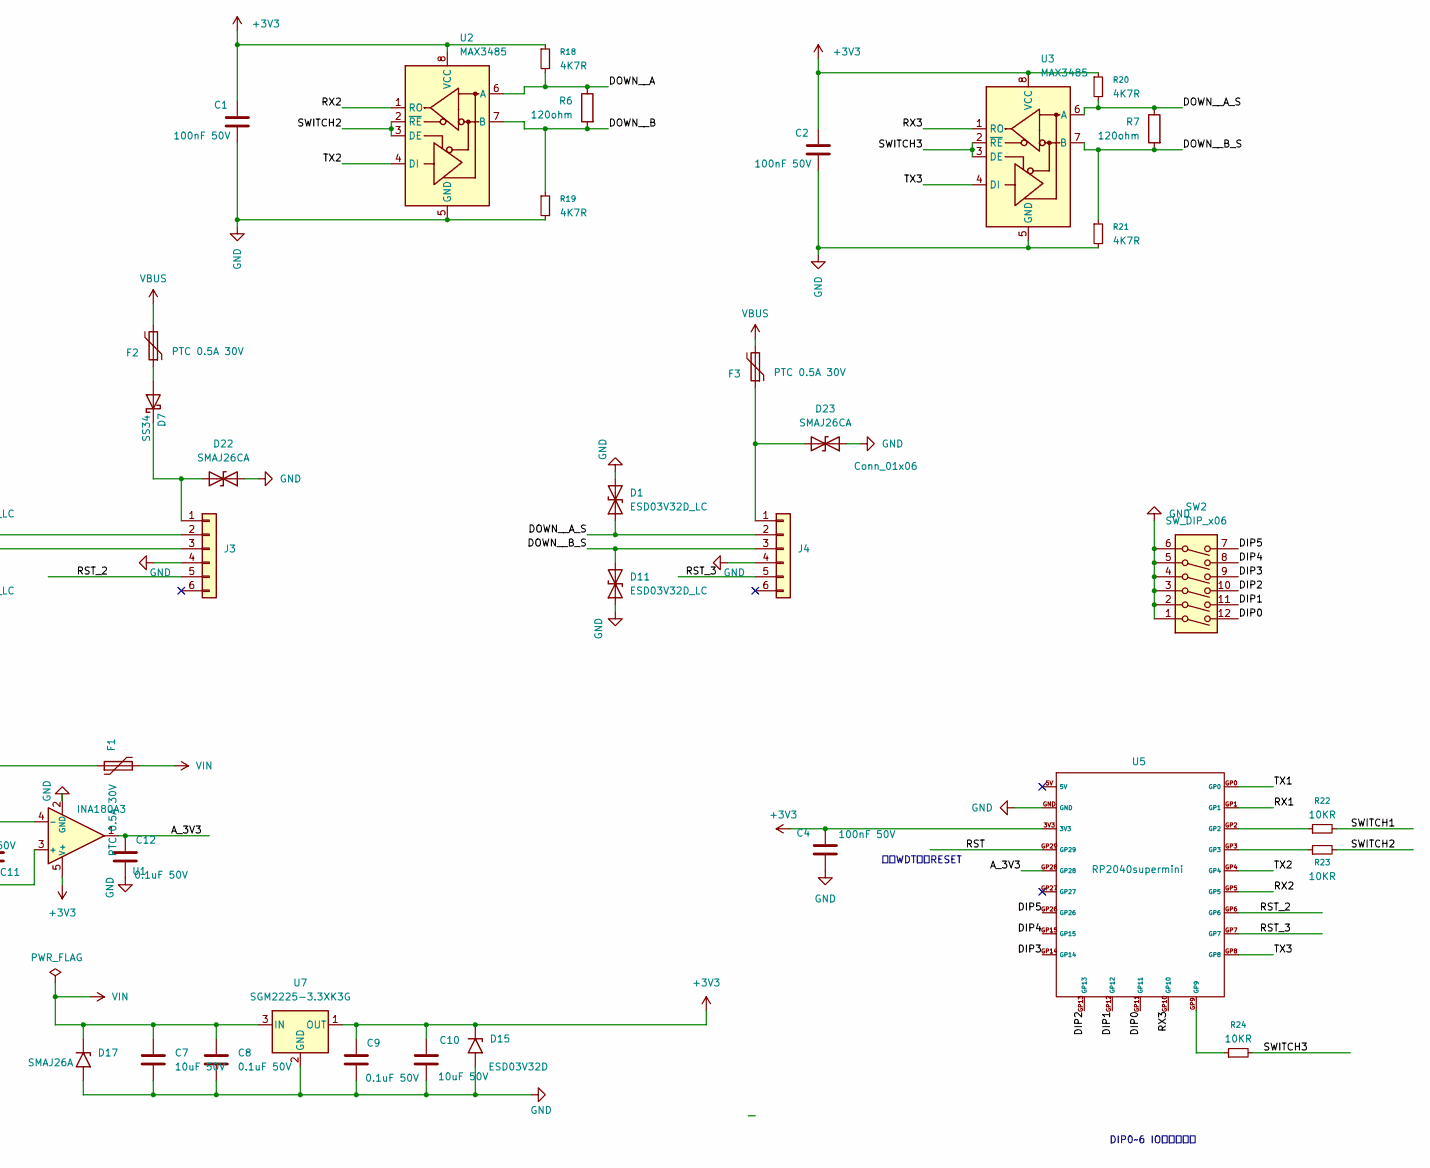
[picture p13: schematic RS485_C_repeater_YJ.kicad_sch, part in row 1, column 2]

Parts:
C1, C2, C3, C4: 100nF 50V; C_0805_2012Metric_Pad1.18x1.45mm_HandSolder_RECT
C6: 100uF 50V; CP_Radial_D8.0mm_P3.50mm_RECT
C7, C10: 10uF 50V; C_1206_3216Metric_Pad1.33x1.80mm_HandSolder_RECT
C8, C9, C11, C12: 0.1uF 50V; C_0805_2012Metric_Pad1.18x1.45mm_HandSolder_RECT
D1, D3, D6, D8, D10, D11: ESD03V32D_LC; D_SOD-323_RECT
D4, D22, D23: SMAJ26CA; D_SMA_RECT
D5, D7, D14: SS34; D_SMA_RECT
D13, D17: SMAJ26A; D_SMA_RECT
D15: ESD03V32D; D_SOD-323_RECT
D16: LED; LED_0805_2012Metric_Pad1.15x1.40mm_HandSolder_RECT
F1, F2, F3: PTC 0.5A 30V; Fuse_1206_3216Metric_Pad1.42x1.75mm_HandSolder_RECT
F4: PTC 3A 30V; Fuse_1206_3216Metric_Pad1.42x1.75mm_HandSolder_RECT
J1, J2, J3, J4: Conn_01x06; PinHeader_1x06_P2.54mm_Horizontal_RECT
J5: Barrel_Jack_Switch; BarrelJack_GCT_DCJ200-10-A_Horizontal_RECT
L1: 3.3uH; L_Changjiang_FXL0420_RECT
Q3: 5n10; SOT-23_RECT
R1, R6, R7: 120ohm; R_0805_2012Metric_Pad1.20x1.40mm_HandSolder_RECT
R4: 12KR; R_0805_2012Metric_Pad1.20x1.40mm_HandSolder_RECT
R5: 20m ohm; R_1206_3216Metric_Pad1.30x1.75mm_HandSolder_RECT
R11: 100K; R_0805_2012Metric_Pad1.20x1.40mm_HandSolder_RECT
R12: 220R; R_0805_2012Metric_Pad1.20x1.40mm_HandSolder_RECT
R13, R15, R18, R19, R20, R21: 4K7R; R_0805_2012Metric_Pad1.20x1.40mm_HandSolder_RECT
R14: 10k; R_0805_2012Metric_Pad1.20x1.40mm_HandSolder_RECT
R22, R23, R24: 10KR; R_0805_2012Metric_Pad1.20x1.40mm_HandSolder_RECT
SW2: SW_DIP_x06; SW_DIP_SPSTx06_Slide_Copal_CHS-06B_W7.62mm_P1.27mm_RECT
U1: INA180A3; SOT-23-5_RECT
U2, U3, U4: MAX3485; SOIC127P600X175-8N_RECT
U5: RP2040supermini; RP2040_Super_Mini_Socket_RECT
U6: AQY212S; SO-4_4.4x4.3mm_P2.54mm_RECT
U7: SGM2225-3.3XK3G; SOT-89-3_SGM2225_Handsoldering_Engrave_RECT

Connections:
+3V3: C1.1, C2.1, C3.1, C4.1, C9.1, C10.1, D15.1 (A1), R11.1, R12.1, R13.1, R18.1, R20.1, U1.5 (V+), U2.8 (VCC), U3.8 (VCC), U4.8 (VCC), U5.3V3, U7.1 (OUT)
/A_3V3: C12.1, U1.1, U5.GP28
/DIP0: SW2.12, U5.GP11
/DIP1: SW2.11, U5.GP12
/DIP2: SW2.10, U5.GP13
/DIP3: SW2.9, U5.GP14
/DIP4: SW2.8, U5.GP15
/DIP5: SW2.7, U5.GP26
/DOWN__A: D6.1 (A1), J3.2, R6.1, R18.2, U2.6 (A)
/DOWN__A_S: D1.1 (A1), J4.2, R7.1, R20.2, U3.6 (A)
/DOWN__B: D10.2 (A2), J3.3, R6.2, R19.1, U2.7 (B)
/DOWN__B_S: D11.2 (A2), J4.3, R7.2, R21.1, U3.7 (B)
/RST: J1.5, J2.5, U5.GP29
/RST_2: J3.5, U5.GP6
/RST_3: J4.5, U5.GP7
/RX1: U4.1 (RO), U5.GP1
/RX2: U2.1 (RO), U5.GP5
/RX3: U3.1 (RO), U5.GP10
/SWITCH1: R22.2, U4.2 (~RE), U4.3 (DE)
/SWITCH2: R23.2, U2.2 (~RE), U2.3 (DE)
/SWITCH3: R24.2, U3.2 (~RE), U3.3 (DE)
/TX1: U4.4 (DI), U5.GP0
/TX2: U2.4 (DI), U5.GP4
/TX3: U3.4 (DI), U5.GP8
/Tem_R_OUT: J2.6, Q3.1 (G), R11.2
/UP_A: D3.1 (A1), J1.2, J2.2, R1.2, R4.2, R13.2, U4.6 (A)
/UP_B: D8.2 (A2), J1.3, J2.3, R4.1, R15.1, U4.7 (B), U6.3
GND: C1.2, C2.2, C3.2, C4.2, C6.2, C7.2, C8.2, C9.2, C10.2, C12.2, D1.2 (A2), D3.2 (A2), D4.1 (A1), D6.2 (A2), D8.1 (A1), D10.1 (A1), D11.1 (A1), D13.2 (A2), D15.2 (A2), D16.1 (K), D17.2 (A2), D22.1 (A1), D23.1 (A1), J1.4, J1.6, J2.4, J3.4, J4.4, J5.2, J5.3, Q3.2 (S), R15.2, R19.2, R21.2, SW2.1, SW2.2, SW2.3, SW2.4, SW2.5, SW2.6, U1.2 (GND), U2.5 (GND), U3.5 (GND), U4.5 (GND), U5.GND, U7.2 (GND)
unnamed: C11.2, D5.1 (K), R5.1, U1.3 (+)
unnamed: D7.2 (A), F2.1
unnamed: D13.1 (A1), F4.2, L1.1
unnamed: C6.1, D14.2 (A), L1.2, R14.2
unnamed: D16.2 (A), R14.1
unnamed: D7.1 (K), D22.2 (A2), J3.1
unnamed: D23.2 (A2), F3.1, J4.1
unnamed: F4.1, J5.1
unnamed: Q3.3 (D), U6.2
unnamed: R1.1, U6.4
unnamed: R12.2, U6.1
unnamed: R22.1, U5.GP2
unnamed: R23.1, U5.GP3
unnamed: R24.1, U5.GP9
unnamed: C11.1, F1.1, R5.2, U1.4 (-)
VBUS: D4.2 (A2), D5.2 (A), D14.1 (K), F2.2, F3.2, J1.1, J2.1
VIN: C7.1, C8.1, D17.1 (A1), F1.2, U7.3 (IN)

Notes on the sheet:
Per-DOWN-port PTC: a short in one branch only drops that branch. C9: 5V_SRC bulk (hot-plug hold-up), place near U2 / D10.
DIP0~6 IO採內建上拉
利用WDT強制RESET
