PeiaLo/RS485C/hardware/PCB/RS485_C_repeater_YJ.kicad_pcb

## KiCad design hardware/PCB/RS485_C_repeater_YJ.kicad_pcb (continued)

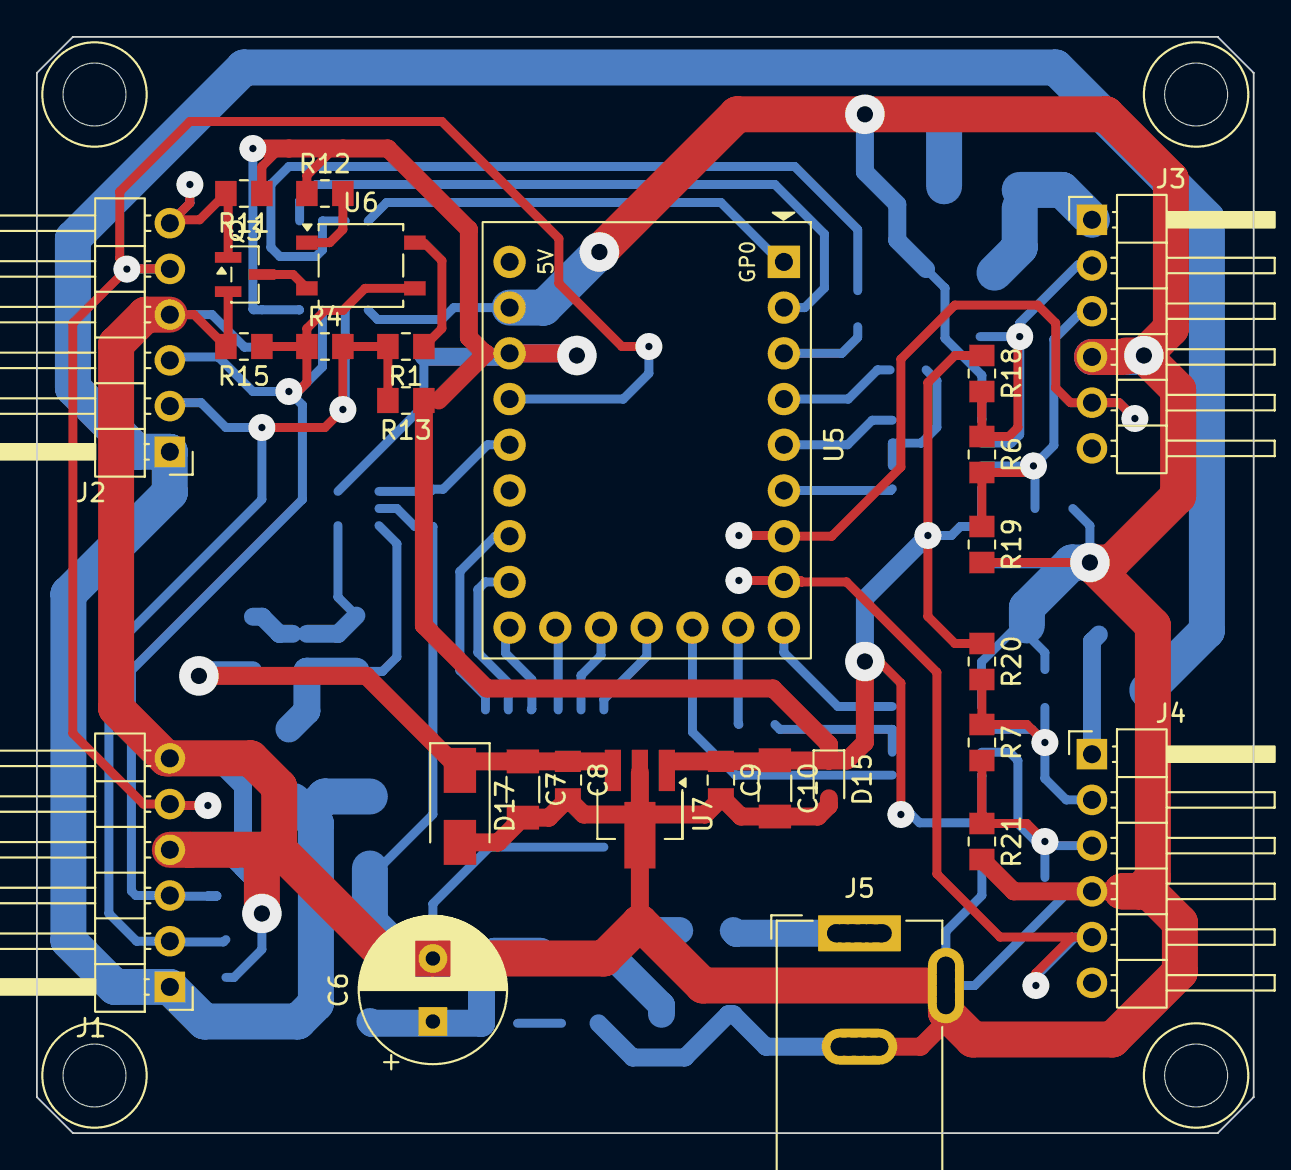
[picture p14: board RS485_C_repeater_YJ.kicad_pcb from above]

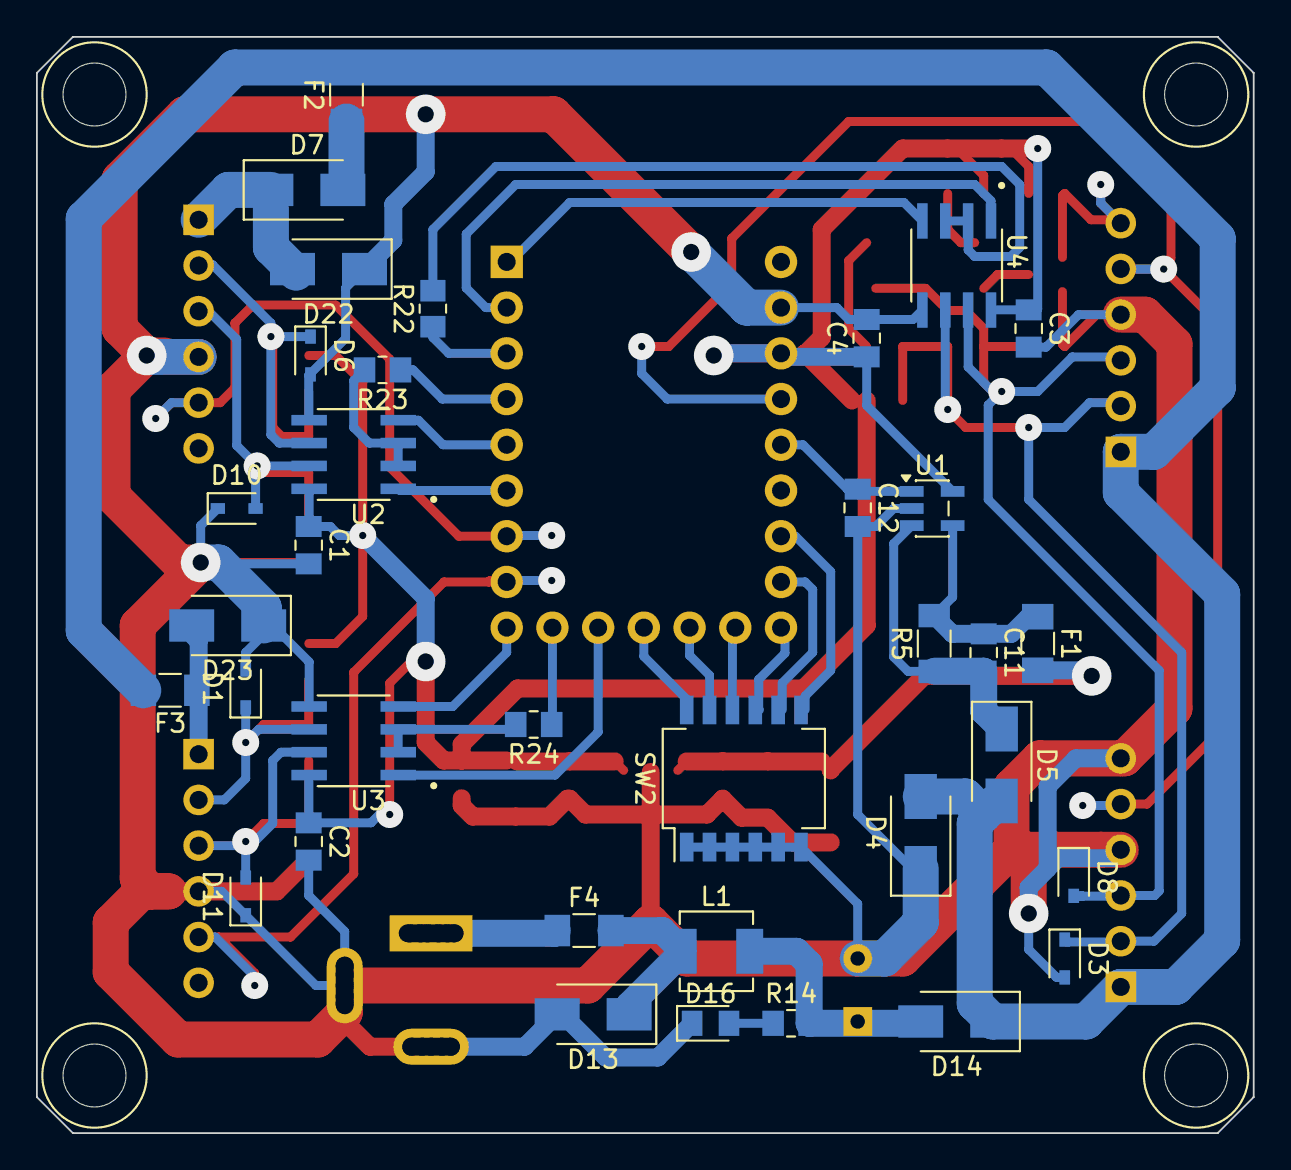
[picture p15: board RS485_C_repeater_YJ.kicad_pcb from below]

Board: 2 copper layers, 67.6 x 60.9 mm, 64 parts (35 on the bottom side), 45 nets.

Other parts of the board:
BRD1: Outline_M3; RS485_C_repeater_YJ_Outline_M3
