PeiaLo/RS485C/(commit log)

2026-08-14 初始化 RS485_C：多層樹狀傳感器網路
    - 架構/協定/定址/模組拆分/測試/決策文件 (docs 01–06)
    - 圖像化：架構總覽 + 進度追蹤 (docs/*.html)
    - JSON schema + 溫度/壓力範例
    - Stage 0 兩節點程式：UNO 末端 + ESP32 主端 + 接線文件
    - 各韌體/上位機骨架 README
    接替並取代舊 R_C_MOD，與 ACL_001 獨立。
2026-08-14 加入 .gitattributes 統一跨平台換行
2026-08-18 進度追蹤頁：標記已上 GitHub、補 repo 連結
2026-08-18 拆分子專案：6 模組 kickoff brief（分對話開發）
    - 子專案/00_拆分總覽.md：拆分地圖、依賴、開對話節奏
    - 子專案/{C,E,A,B,D,F}_*.md：各模組範圍/介面/DoD/狀態 + 貼到新對話的開場白
    - README 導覽補上 子專案/
2026-08-18 契約定版：模組 C 協定庫 + 模組 E schema
    模組 C（lib/）：\n/\r 框架 + <位址>|<json> + 位址操作，C++/Python 兩份一致實作。
    - protocol.py（MicroPython/CPython 相容）、protocol.h/.cpp（AVR 安全，純 char buffer）
    - test_vectors.json 為唯一真相來源；test_protocol.py 驗 Python(49/49)並產生 test_vectors.h
    - test_protocol.cpp 為 host(g++) C++ 測試
    - 定版決策：per-record emit 解碼、只做框架+位址（不含 REQ|/CFG|）、CRC 停用但預留 *<crc16> 接口
    模組 E（schema/）：完善 device.schema.json（additionalProperties:false、多值量測、
    role:output 佔位欄位），新增 RH/DI/ENV/DO 範例，寫 validate.py（jso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
2026-08-19 docs/06 §H 前端冗餘定案 + sim/ 容量與鏈路預算腳本
    §H 拓樸韌性/前端冗餘（定案 2026-08-19）：
    - 兩道牆：牆A頂層頻寬(限總量,MAX13487≈1250筆/s→實務約2層數千台)、
    牆B端到端延遲(限層數)；定址非瓶頸(最大末端63^D)。
    - 分層韌性：全體看門狗+多數溫備援+頂層熱備(依故障半徑分配)。
    - 前端中繼器(PC下那台,唯一全樹單點)=熱備：主+備偷聽保溫+PC仲裁自動failover；
    上行走兩條點對點快速RS485(選項A,THVD1450/MAX3485級,偏離免DE/RE慣例但P2P可接受)；
    後端主+備共掛同一條第1層bus(零複製,master不佔位址→仍63台)；
    已知缺口:第1層bus共享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
2026-08-19 sim/stage0.py：Stage 0 一主一末端模擬（走 lib/protocol.py）
    硬體無關地驗證 REQ 輪詢、\r 收尾、逾時 stale，對應兩支 Stage0 .ino。
2026-08-20 Stage 0/1 硬體韌體：2×ESP32 + UNO，皆用 lib/protocol.*
    - firmware/esp32_master：輪詢 {4,5}、FrameDecoder+parse_payload 解框
    - firmware/esp32_terminal：末端 addr4（ESP32）
    - firmware/uno_terminal：末端 addr5（AVR，dtostrf/F()/SoftwareSerial）
    - firmware/sync_lib.sh：把 lib 副本同步進各 sketch（副本已 gitignore）
    - firmware/STAGE0_兩台ESP32.md：Stage0(2×ESP32 TTL 免分壓) → Stage1(加UNO真RS485)
    - 燒錄能通即在真硬體驗證 C++ 協定庫
2026-08-22 進度追蹤頁對齊定版：契約(C+E)已定版、Stage0改模擬驗證、硬體改2×ESP32
2026-08-26 架構總覽 §08 待拍板 → 決策狀態（已定/待你回）
2026-08-31 docs/06 §I 邊緣控制/PID：末端=感測+作動+本地PID，網路轉監督角色
    - PID 放本地(邊緣)，確定不做在 PC；中繼器多區則升樹莓派
    - 網路=supervisory(回報+下發設定點)，控制不吃輪詢
    - 放置依迴路速度：快迴路(馬達)必邊緣、慢迴路(溫控)可中繼器/RPi
    - fail-operational + e-stop 廣播 + safe_state
    - 待定：參數來源、SET下行協定、schema controller/control 區塊
2026-08-31 docs/06 §I 定案：放置策略(I/O在哪就在哪控)、PID參數兩者、中繼器上下各一顆收發器
    - 放置=I/O 所在即控制點；快迴路強制末端；上移只為「協調多末端」非「慢」
    - PID 參數來源=兩者(PC下發+末端本地預設)
    - 中繼器上/下行各一顆 RS485 IC+各一 UART，不共用串接(上下=兩條獨立bus)
    - 仍待定：SET 下行協定 + schema controller/control 區塊(建議現在定)
2026-08-31 docs/06 §J 去陸製→STM32：ESP32(中國)換 STM32(歐)，RPi只放最末端，WiFi→Ethernet(W5500)
2026-08-31 docs/06 §K 快取hold-last-value+age、末端多ADC(per-measurement channel/校正)、設備型錄
2026-08-31 docs/06 定案：中繼器=MicroPython/末端=C++、型錄=單一大檔、熱替換靠中繼器推設定
2026-09-01 docs/06 §L + docs/07 採購清單：控制細項暫訂、\n語意待對齊、選料/庫存/兩層測試
    - ⚠️ \n 語意 user原意(同筆未完) vs lib定版(批次分隔)不一致，批次前需拍板
    - SET多鍵原子套用+ACK、PC可SET、e-stop位址0廣播
    - 無C系列適配MicroPython(C=48腳封裝;C0太小);甜蜜點F4/F7/H7
    - 無線暫緩→若LoRa用STM32WL(非陸);骨幹仍Ethernet(W5500)
    - 庫存10×MAX13487+2×THVD1426;先兩層、雕刻機刻板>0.35mm
    - docs/07 非陸製BOM
2026-09-01 STM32 Stage 1 韌體：MicroPython 中繼器(module B v0.1) + C++ 末端
    - repeater_micropython/main.py：輪詢+cache(hold-last-value+age)+逐跳前綴+上層服務，用 protocol.py
    - stm32_terminal/stm32_terminal.ino：STM32duino 末端(F103/F401)，用 protocol.h/.cpp
    - STAGE1_STM32.md：半雙工 MAX13487 接線、工具鏈、跑法
    - sync_lib.sh 擴充(含 .py 到中繼器)、.gitignore 加 protocol.py
2026-09-01 firmware/sync_lib.bat：Windows 雙擊版同步腳本（.sh 需 Git Bash）
2026-09-01 fix(stm32_terminal): F401CC 無 PC0/PC1，DIP 腳改 PA/PB 且用 #if USE_DIP 包起來
    [stm32_terminal.ino]
2026-09-01 docs(STAGE1_STM32): DevEBox 黑膠丸燒錄踩雷（BT0非K0、CDC序列埠、ST-Link備援）
2026-09-01 feat(stm32_terminal): USB CDC 等待host再印開機訊息 + LED(PC13)心跳
2026-09-01 feat: nucleo_master.ino — Nucleo(C++) 當測試 master，可靠 VCP 序列埠
2026-09-01 fix(nucleo_master): Nucleo 變體無 Serial1，改自建 HardwareSerial(PA10,PA9)
    [nucleo_master.ino]
2026-09-02 nucleo_master: 濾掉 RS485 半雙工回音/雜訊(只收 addr_valid 的記錄)
2026-09-02 stm32_terminal: 加 COM9 診斷輸出(每秒心跳+rxBytes計數+印收到的整行)
2026-09-02 pc/rs485_probe.py：Python RS485 探針(每秒送REQ+印hex)，取代 Arduino 監控除錯
2026-09-02 move rs485_probe.py 到專案根目錄方便執行
2026-09-02 rs485_probe: 串口斷線自動結束，不再卡死 PowerShell
2026-09-02 firmware/stm32_maxtest：MAX13487 自檢(自我回音)，單獨判斷收發器好壞
2026-09-02 加第2台末端 + 進度更新
    - firmware/nucleo_terminal：Nucleo 末端 addr 5(HardwareSerial、VCP、起始溫度20)
    - rs485_probe.py：支援多位址輪詢(REQ|4,5)測 multidrop
    - 進度追蹤頁：真 RS485 跑通 + 換 STM32
    - sync_lib 納入 nucleo_terminal
2026-09-02 fix sync_lib.sh: nucleo_terminal 補上 firmware/ 前綴
2026-09-02 firmware/nucleo_maxtest：Nucleo 版 MAX13487 自檢
2026-09-03 firmware/nucleo_repeater：C++ 中繼器(輪詢+cache+前綴 1-4，上層走VCP免收發器)
2026-09-03 nucleo_repeater: 上層改走 USART6+MAX(RS485)，完整兩顆收發器中繼器
2026-09-03 nucleo_repeater: 加上層診斷(up_rx計數+cache狀態,印在VCP/COM8)
2026-09-03 maxtest: 120Ω 改為必接(負載驅動器,揪出沒供電卻幽靈供電假OK的晶片)
2026-09-03 probe: 寫入設 1s 逾時，FTDI 卡住時探針會結束而非卡死
2026-09-03 repeater: 輪詢等待期間持續 serveUpstream，快取真正解耦 PC 不被下層 200ms 卡住
2026-09-03 進度追蹤：樹狀三層端到端跑通 + 修正接線鐵則(偏壓/120Ω/A-A B-B/共地非主兇)
2026-09-03 docs/06 §M：設備健康狀態機(ok/up/rst)+熱插拔偵測；ID=7位指撥=位址；在位偵測腳選配
2026-09-03 健康監測：末端上報 up(uptime)/rst(RCC_CSR重置原因)/ok + IWDG看門狗；中繼器cache緩衝加大；schema/README補health envelope
2026-09-04 測試: 可搬動末端(PB0選址 開路=addr5第二層/接GND=addr2第一層)驗末端不同階層；repeater children={4,5}。本機arduino-cli全編過
2026-09-04 工具: rs485_monitor.py 一個視窗多埠監看(每埠一色+時間戳+標籤,可設探針),PC上位機(模組D)雛形
2026-09-04 docs: 下層RS485已知良好基準(乾淨log片段+正常判準表+電阻黃金法則),日後退化比對用
2026-09-04 bus baud 降到 38400(給麵包板回穩餘裕,VCP除錯仍115200); monitor 支援每埠 baud(標籤@baud)
2026-09-07 MicroPython 中繼器(模組B) 對齊 C++ 版: baud 38400、up=UART(6)+MAX1、快取解耦、每秒診斷(up_rx/down_rx/frames/last/cache)
2026-09-07 docs/06 選型修正: 中繼器改「簡單=C++/STM32、複雜=RPi+Python」,拿掉MicroPython(F401RE預設build只1顆UART、需2顆做不到)
2026-09-08 深鏈1-2-3-7驗通: RP2040/MicroPython中繼x3 × STM32末端, 端到端 7→3-7→2-3-7→1-2-3-7
    新架構(換掉舊版): 中繼器全RP2040(MicroPython雙UART), 末端全STM32(C++/FT 5V容忍)。
    Nucleo/F401 MicroPython中繼廢棄(單UART, 兩UART做不到)。
    - firmware/rp2040_repeater/main.py: 由Nucleo版移植; down=UART0(GP0/1)/up=UART1(GP4/5)
    避開W5500(GP16-21, ETH板也能用); 抽出設定區(三台同檔, 只改MY_ADDR=1/2/3, CHILDREN=[7]);
    MANUAL_DIR旗標(13487免方向, 檔尾留13485 DE/RE+排空作法) +README
    - stm32_terminal.ino: FIXED_ADDR 4→7; BUS改明確實例化 HardwareSerial(PA10 RX1/PA9 TX1),
    修 STM32duino "undefined reference to Serial1"
    - docs/hardw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
    [main.py, stm32_terminal.ino]
2026-09-09 進度追蹤：更新到深鏈1-2-3-7(4層)驗通+RP2040 MicroPython中繼；選型/決策/待辦同步
2026-09-09 docs/08: §3 補 MCU分級(F411通用/RP2040特用/F7-H7重運算)+收發器選型(5V AutoDir/5V fail-safe/TI 3.3V fail-safe,分段角色,速度×距離); §7.4 節點分類(5型+5拆分規則+輸出3歸屬)+外設容量(慢可到63/快要獨立)
2026-09-09 docs/08 §3.1: F7/H7/N6 依特性拆分(M7/cache/DP FPU/16-bit ADC/雙核/NPU)+何時往上跳; 修掉 ESP32-S3(去陸製)
2026-09-09 架構總覽: 決策狀態更新到深鏈1-2-3-7+RP2040/STM32選型; 角色/模組/測試階段/收發器/骨幹去掉ESP32/AVR過時內容
2026-09-14 docs/09 軟體架構定案(彙整)+docs/02 編碼定案
    - docs/09: 模組地圖/協定分層/資料模型/指標式資料存取(函式指標driver表+值槽零複製)/資料流/平台分工/四道防線韌性/現況待實作
    - docs/02 §3.1: DESC=JSON / REQ=純值CSV(descriptor定順序) / CRC-16 MODBUS(逐跳重算) / age+health envelope移出payload(中繼器純轉發) / 指標式組裝
2026-09-15 docs: 精簡兩份 bring-up 血淚為架構參考
    known_good_baseline: 去掉基準日期/COM配置/monitor快照/正常-壞掉症狀表/重現指令,
    留下電氣黃金法則(每bus 4顆電阻+極性+/RE)+距離速度台數+準位表。
    bringup_1237: 去掉COM對照/逐板pinout/Thonny-STLINK燒錄協調/USB重列舉/by-COM驗證,
    留下4層拓撲(架構驗證基準)+接線通則+UART慣例。
    age疊3層缺陷仍記於09/02。
2026-09-16 docs+子專案: 消除與最後結論牴觸的平台/編碼字樣
    子專案 A–F + 00：ESP32→RP2040 中繼、Arduino→STM32 末端、一律JSON→DESC/純值CSV+CRC、
    WiFi→Ethernet(W5500)、CRC先不做→啟用；狀態刷新為深鏈1-2-3-7已驗通。
    docs/01,04,05,07：同步平台字樣(RP2040 中繼/STM32 末端/Ethernet)，移除 AVR/UNO/WiFi 末端。
    docs/06 §J：修正中途誤判——中繼器不是「改C++/STM32」而是 MicroPython on RP2040(雙UART)；
    F401RE 因1-UART淘汰、ESP32去陸製排除；決策紀錄表與待確認項標註超越/已定。
    架構總覽.html：Stage0 ESP32↔UNO→RP2040↔STM32、頂層 Ethernet(W5500)。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
2026-09-16 docs/08: 跨節點控制放置定則(§7.3)+安全兜底(§9.5)
    放置定則：控制迴路住在能同時看到所有輸入又搆得到輸出的最低節點
    (單末端→末端µs / 跨末端→子樹中繼器輪詢級 / 跨樹→根或PC)。
    中繼器選配「控制帽」讀cache+SET下發;快+跨節點=polled RS485做不到→硬體同末端。
    §9 補第5道:跨節點迴路的中繼器一斷→輸出回safe_state+PC re-push,是安全停非失控。
2026-09-16 docs: 線上協定定案 edge=MODBUS / core=私有格式(0xFE)
    第一 byte 判別:1-63/0xFF=MODBUS、0xFE=私有(\r前驗CRC)。
    分層:末端↔外設(master@115200)與末端↔中繼器(末端=slave,cache值當暫存器)走MODBUS;
    中繼器骨幹走私有格式高速RS485,第一台中繼器轉格式+起 path。
    外設不進樹狀定址(蓋掉「外設=一等公民可定址」):path只到節點,外設由node cache+descriptor索引。
    JSON僅首次連接自描述+每10s存活檢查。CRC-16/MODBUS啟用。
    新增:08 §4.1傳輸分層、§6.1 modbus綁定塊、§6.2暫存器佈局提案(待確認)、末端雙MODBUS角色;
    06 §N決策紀錄;02 §3.1改寫;03/09同步。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
2026-09-16 子專案 A–E: 對齊 edge=MODBUS / core=私有格式 模型
    A 末端:對上=MODBUS slave(cache值→暫存器)、對下=MODBUS master@115200讀外設進cache;
    DESC/JSON走0xFE;外設不進樹狀定址。
    B 中繼器:葉段 down=MODBUS master讀末端暫存器→轉私有格式;骨幹兩側私有、子中繼器純轉發;up_baud≠down_baud。
    C 協定庫:第一byte判別 + 私有格式(0xFE)與MODBUS RTU兩套框架 + CRC-16共用;介面改列。
    D PC:解析私有格式0xFE、位址到節點。E schema:measurements順序一序三用(私有CSV/末端暫存器/binding.modbus)。
    00 提醒改寫為第一byte判別+edge/core+外設不定址。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
2026-09-17 docs: 新增 4 中繼器+Pico Mini 通訊測試錨點
    - bringup_4rep_picomini.md：以 proven 深鏈 1-2-3 為骨幹、
    R3 下層升級 multidrop+混掛、新增 R4(Pico Mini) 帶葉 bus 的驗證錨點
    - 含拓樸(mermaid)、DIP/位址/path 表、偏壓/終端配置(每 bus 一組)、
    分階段 bring-up 清單(P0 回歸→P1 孤立新板→P2 展開→P3 韌性)
    - hardware_4rep_picomini.svg：配套對照接線圖(仿 hardware_1237.svg)
2026-09-17 docs: 錨點更新收發器庫存與分配(8×13487 + 10×13485E)
    - 庫存更正：8×MAX13487(AutoDir·要偏壓) + 10×MAX13485E(手動DE/RE·
    true fail-safe 免偏壓) + 2×THVD1426(備援) = 20
    - 分配：proven 部分沿用已焊 13487；新增(R4+5末端)全上 13485E
    - 偏壓改為「凡 bus 含 13487 就要一組」→ 葉 bus 全 13485E 免偏壓，
    偏壓由 4 組降為 3 組(M/L/XL)；560Ω BOM 8→6
    - 新增 §5.2 13485E 手動 DE/RE 接線(DE+/RE 綁同 GPIO、MANUAL_DIR、
    txdone 後才放腳)；分階段清單加入手動控向與混收發器驗證
    - 同步 hardware_4rep_picomini.svg：收發器類型標註、葉 bus 免偏壓、
    Panel② 規則/BOM/收發器分工更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
2026-09-23 firmware: 末端 13485 手動DE/RE + PC13心跳修正 + reset順序 + baud 115200
    - stm32_terminal.ino：MANUAL_DIR(13485E 手動 DE/RE，DE_PIN=PB0、flush() 後才放腳)；
    LED 心跳寫死 PC13(LED_BUILTIN 在 Generic F411CEUx 不指 PC13)；
    detectResetCause 先判 POR 再判 BOR(F4 上電同時設兩旗標，避免誤報 bor)；BUS_BAUD→115200
    - rp2040_repeater/main.py：MANUAL_DIR 旗標 + _tx() 控向(down=GP2/up=GP3)；BAUD→115200
    - 3R3T 實機驗證：REQ|4/5/6 → 1-4 / 1-2-5 / 1-3-6，rst=por
2026-09-23 docs: 新增 3R3T 簡化測試錨點 + 接線概念圖
    - bringup_simple_3r3t.md：R1 下並掛 R2/R3/T1、R2→T2、R3→T3 的 3 中繼器+3 末端最小拓樸；
    扁平葉位址模型 CHILDREN 設定、分階段驗證清單
    - hardware_simple_3r3t.svg：bus1-4 系統樹 + 每節點接線/偏壓/燒錄連線
    - 中繼器=13487(AutoDir)、末端=13485E(手動 DE/RE)、baud 115200
2026-09-23 docs: 02 實體層對齊雙速IC/獨立bus + 08 driver 通用庫(I2S/4~20mA)
    - 02 §1：中繼器 3 條獨立 bus(UP/DOWN-trunk/DOWN-leaf)、骨幹高速IC/對末端低速IC、
    目前先用 13487 過渡、baud per-bus 獨立
    - 08 §6/§7：binding 加 i2s、adc 拆電壓/4~20mA；新增通用 driver 庫表；
    後段由 descriptor 人工指定 vs bus 自動探索的界線
2026-09-23 docs: 記錄 3R3T 實測結果(功能/soak/斷電恢復) + 3.3V 收發器摸底
    - bringup_simple_3r3t.md §6：驗證結果全 PASS（REQ|4/5/6→1-4/1-2-5/1-3-6、
    rst=por、bus2 多中繼器混掛、13485 手動 DE/RE）；6.1 soak 366輪0異常；
    6.2 斷電恢復 R1~R3/T1~T3（blast-radius 侷限 + hold-last-value + 乾淨恢復）
    - known_good_baseline.md：13487/13485E 硬降 3.3V 四組對照表 + 「混壓才是掉封
    元凶、電壓一致就乾淨」結論 + 超規/長線界線 + 「先 VCC 3.3V 再拆分壓」鐵律
2026-10-07 docs/02: 新增 §3.2 量測 payload 格式候選(CSV / 縮寫 KV)
    - 兩組 JSON 定位：① 組態 descriptor 永遠 JSON、不動；② 量測資料要瘦身
    - CSV(值-only ~13B) / 縮寫 KV(key=val ~19B) / JSON(~40B) 對照表
    - 釐清「不轉譯」與「byte 少」可兼得：末端直接吐最終格式、中間只前綴不解析
    - 二進位先不採用、保留第一 byte 旗標後路；純速度優先靠拉 baud(與格式正交)
    - ⏳ ② 量測資料選 CSV(重密度) 還是 KV(重除錯) 待定
2026-10-07 docs/02: 修正 §3.2 轉譯點 — 在第一台中繼器(非末端)
    edge=MODBUS：末端對上是 MODBUS slave(暫存器)，第一台中繼器讀暫存器
    → 轉文字格式一次，之後 backbone 每跳只前綴 path+重算 CRC、不解析。
    原文誤寫「末端直接吐最終格式」，與 edge=MODBUS 不符，改正。
2026-10-13 docs: 彈性定架 v2 核心——三段式 + 自動定址(ENUM) + 去 DIP
    06 §O:總原則=頭/尾可插拔通用 adapter、核心 RS485 不動;MODBUS 降為尾段其一;
    WiFi(非陸製模組)回歸頭段無線;DIP 全拿掉改拓樸自動定址。
    10 §8:in/out 連接器加 ENUM 鏈致能線;master 點名枚舉、每台領鏈序後放行下一台→實體順序;
    全路徑=父path+鏈序、換板重枚舉復位;進階模式改軟體指令。
    03:標題/內容由 7-DIP 改述自動定址;保留字串路徑/逐跳前綴;熱換改「換同款即自動定位」。
2026-10-13 docs+子專案: 推完 v2 連動(三段式/自動定址/頭尾可插拔/保留 JSON DESC)
    01:新增 §0 三段式(頭/核心/尾)、WiFi(非陸製)回歸頭段、§6 熱替換改自動定址+JSON型錄。
    02:§3.1 尾段 adapter 可插拔(MODBUS 預設非唯一)、§6 進階模式改軟體指令、§7 定址改自動。
    04/05:末端讀指撥→自動定址。07:加 WiFi 非陸製模組、ENUM/INA180 偵測件、移除 DIP BOM。
    08:§4.1 加 v2 定架註(頭尾可插拔/自動定址/JSON descriptor 給身分)。
    09:模組圖/資料模型/待實作 由 DIP→自動定址、加頭尾可插拔。
    06:§N/§237 標註被 §O 更新(DIP→自動定址)。
    子專案 00/A/B/C:自動定址(ENUM)、B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
2026-10-13 docs: CRC 改為可選(初期不設/後加/不影響硬體) + 節點硬體增減清單
    CRC:02/06/09 + 子專案 A/C 由「啟用/已定」改回「可選」——*<crc>槽與 crc16() 預留、
    CRC_ENABLED 預設 False、純軟體不影響硬體;feat/modbus 實作可日後併入。
    07:新增「v2 節點硬體增減 vs DIP 版」——
    新增 ENUM線+GPIO/INA180 shunt/可切換終端/連接器加pin/頭段WiFi或乙太/中繼器3收發器/末端第2埠;
    移除 DIP+74HC165/固定尾端120Ω/偏壓/分壓/RST腳/AutoDir收發器;CRC 不影響硬體。
2026-10-14 docs: 新增 14 易用性賣點與故障處理(口述整理)
    忠實整理使用者口述:便利賣點(安裝機構/換機維運/防呆/PC)+故障處理流程
    (畫面引導分層、UI位置示意圖、開箱看出哪顆、外殼寫編號)。
    標記待定/排除/需後續延伸;不新增不延伸。
2026-10-14 docs/14: 記下待考慮——外設腳的編號方式怎麼記(掛在快接模組下)
2026-10-31 hardware: 納入 KiCad 專案(repeater / repeater_YJ / terminal) + .gitignore 排除 KiCad 暫存
    - 只追蹤原始檔：.kicad_pro/.sch/.pcb、fp/sym-lib-table、RS485_C.pretty、New_Library.kicad_sym
    - 排除 .history/(本機歷史)、*-backups/、.kicad_prl、鎖檔、fp-info-cache
    - 順帶排除韌體 *.map
2026-10-31 sim: 新增 PLC 練習用模擬外設(變頻器 unit 1 + 溫控爐 unit 2，含故障注入)
2026-10-31 docs: 補提交 11 中繼器電路規劃 / 12 EASY IO 產品提案 / 13 PLC 模擬練習 + 架構格式流程圖
2026-10-31 docs: 併入 EZ_IO 設計共識 + 解三處衝突
    eastio_design_notes → ez_io_design_notes(EZ_IO);對齊 v2。衝突定案:
    1 定址/編號:一律以 JSON 為主(identity,不依物理位置);ENUM 退為探索+自動終端(06§O-2/03/10§8)。
    2 控制:PC=監督規則、末端=快迴路/本地閉環(與 06§I 一致)。
    3 標示:電子紙優先 + 雷雕並存(取代 14 的外殼手寫)。
    資安:認證 dongle(ATTINY402 keyed CRC32 挑戰-回應,參考 Dungle_ATTINY402.ino)。
    擴充板:連接方式/帶不帶 MCU 先記著。命名定 EZ_IO。
2026-10-31 docs: §3.2 定案核心格式(canonical 核心+邊界 adapter) + 架構圖
    - 原則：中間 backbone 永遠用我們的格式；頭尾 adapter 轉入/轉出
    → 安全(核心受控)/準確(descriptor+CRC)/效率(中繼器零轉譯)
    - ② 量測資料核心格式「先用 JSON」(看得懂/零改動=proven 3R3T)；
    KV 記為提速後路(自描述+省一半)；CSV 極限密度再議
    - 換格式只動「末端吐法 + PC 解析」、中繼器不改 → 隨時可換
    - 提速時機(Claude 主動提醒)：backbone byte 逼近 baud 預算/soak 天花板 → 換 KV
    - 新增 arch_format_flow.svg 架構圖(端到端資料流/幀格式/決策)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
2026-10-31 docs+子專案: 全面對齊 §3.2(canonical 核心 + 邊界 adapter)
    蓋掉舊「末端↔中繼器=MODBUS 暫存器、中繼器 FC04 讀→轉私有」:
    - 末端→中繼器 = 直接吐核心文字(JSON);中繼器 0 轉譯(只前綴 path + 可選 CRC)。
    - MODBUS 只留在末端↔外部外設(尾段 adapter,末端=master);對外互通移到 PC 頭段 adapter。
    - 08 §6.2 由「暫存器佈局」改為「末端直吐文字」;§3/§4.1/§12、09 模組圖/分層/資料流、
    06 §N、子專案 A/B/C 同步。中繼器＝格式無關純管道(換 JSON↔KV 不動)。
2026-10-31 docs: 新增 CLAUDE.md 交接入口(冷啟動導覽+現況+TODO)
    給接手的 Claude:專案定位(EZ_IO/CPO 式 canonical 核心+邊界 adapter)、閱讀順序、
    關鍵定案速記、韌體結構(核心純管道+頭尾 adapter)、現況(設計定案/韌體原型/硬體待測)、
    TODO 分工(韌體實作 vs 硬體測試)、git 現況。
